XxMasterepicxX/ibex-sg13g2-chip/docs/ibex-flow.pdf

Building the Ibex chip on IHP SG13G2 with Synopsys | ibex-sg13g2-chip | Page 1 of 29

# Building the Ibex chip on IHP SG13G2 with Synopsys

### The whole flow from the repository, step by step

Item | Value
Author | Cesar Valentin
Repository | https://github.com/XxMasterepicxX/ibex-sg13g2-chip
Chip | flash_chip: Ibex, two 4 KiB memories, a serial loader, a scan chain and 25 pads
Kit | IHP SG13G2, 130 nm
Tools | Fusion Compiler, StarRC, PrimeTime SI, Formality, PrimePower, TestMAX, VCS, SpyGlass, RedHawk-SC, and KLayout with IHP's rules

Building the Ibex chip on IHP SG13G2 with Synopsys | ibex-sg13g2-chip | Page 2 of 29

## Contents

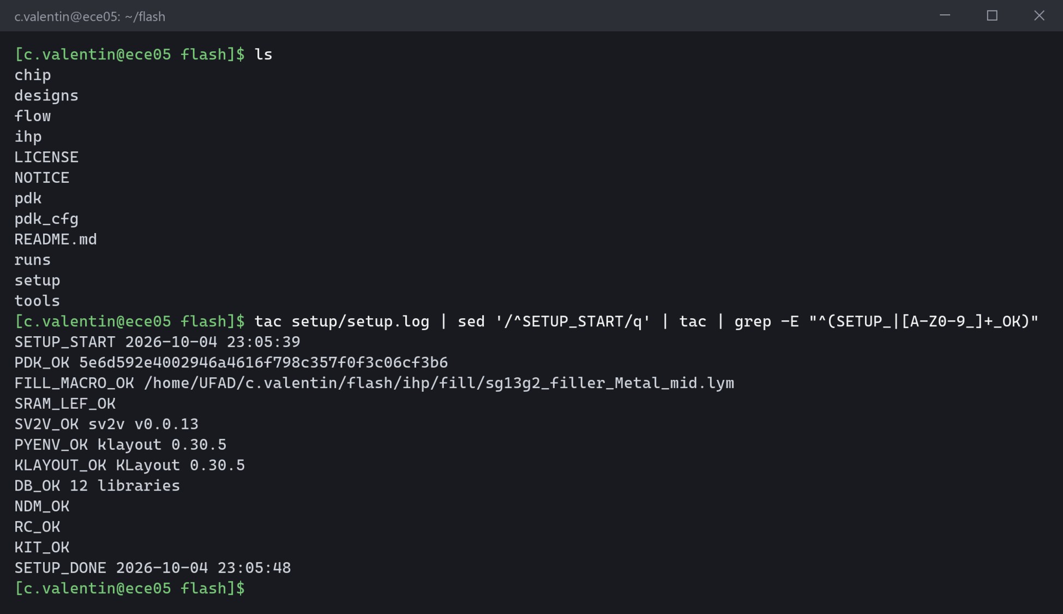
[picture p1: figure]

Building the Ibex chip on IHP SG13G2 with Synopsys | ibex-sg13g2-chip | Page 3 of 29

## Before you start

- Log in to a Linux server with the Synopsys and Ansys tools under /apps. Off campus, use the VPN.
- The scripts load the tools. To start a tool by hand, run source /apps/settings first.
- Fusion Compiler licenses are shared. When none is free, the build waits and tries again.
- Long steps run for hours. Start them under nohup so they keep running after you log out.

### Get the repository and set it up

Clone the repository into ~/flash and run setup once. Every script expects it there.

git clone https://github.com/XxMasterepicxX/ibex-sg13g2-chip.git ~/flash
bash ~/flash/setup/setup.sh

Setup takes about two hours. It downloads IHP's kit, builds KLayout, installs sv2v and the Python packages, and builds the Synopsys libraries and wire models from IHP's kit with your licenses. Those files are in Synopsys formats, so the repository does not hold them. Each step prints a line ending in _OK. If setup stops, the last line names the step and its log says why. Fix it and run setup.sh again. Steps that passed skip themselves.

Figure 1. The end of setup.log from a second run of setup.sh. Each step only checked its result.
Setup is done when ~/flash/setup/setup.log ends with SETUP_DONE.

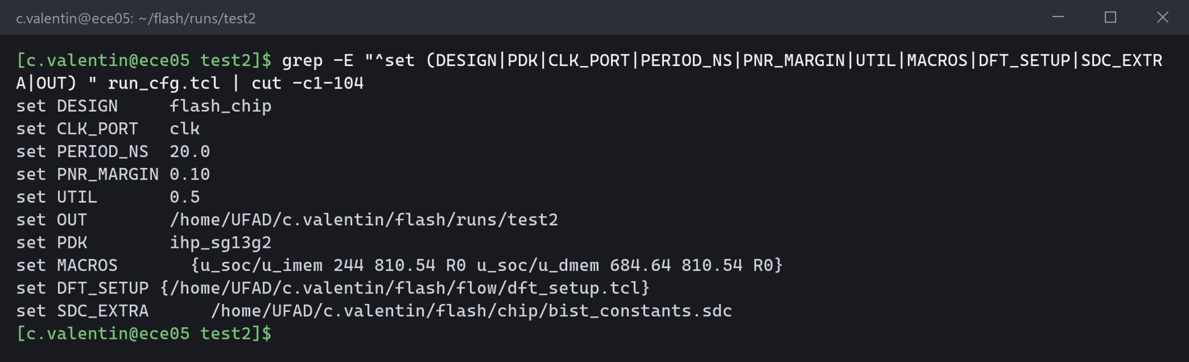
[picture p2: figure]

Building the Ibex chip on IHP SG13G2 with Synopsys | ibex-sg13g2-chip | Page 4 of 29

### What is in the repository

Folder | What it holds
setup/ | the one-time setup
flow/ | the Fusion Compiler flow fc_flow.tcl, run_fc.sh, signoff.sh, the checker check.py, chip finishing finish.sh and the fix loop eco.sh
pdk_cfg/ihp_sg13g2/ | every fact about the IHP kit: layers, cells, corners, pads, bond pads and fill
ihp/ | the scripts that build the Synopsys libraries, and the wire models
designs/flash_soc/ | the RTL, the testbench and the test programs
chip/ | the one-command build, margin rounds, proofs, review records and the release package
runs/<name>/ | one folder per build, made by the scripts

## Stage 1: Make a run

bash ~/flash/chip/new_run.sh my_chip

This makes ~/flash/runs/my_chip with one settings file, run_cfg.tcl, copied from chip/run_cfg.tcl
with the paths set to your home folder. Every later step reads it.
The screenshots come from fresh builds of this repository, named test1, test2 and walk; each caption names its run when it matters. Where they show test2 or walk, your folder is my_chip.

Figure 2. The main settings of the run.

Building the Ibex chip on IHP SG13G2 with Synopsys | ibex-sg13g2-chip | Page 5 of 29
Setting | What it does
DESIGN | the top module, flash_chip: the core inside its pad ring
PERIOD_NS | the clock period signed off, 20 ns or 50 MHz
PNR_MARGIN | 0.10 makes Fusion Compiler aim for a period 10% shorter, 18 ns, to leave room
CORE_SIZE | the core is 900 by 945 µm. With CORE_SIZE set, UTIL is not used
MAX_LAYER | the top routing layer, Metal5. Routing starts at Metal2, so the chip routes on 4 layers
MACROS | where the two memories go, in µm from the lower left corner
DFT_SETUP | how to build the scan chain
SDC_EXTRA | holds the memories' unused self-test clocks at 0 for timing
OUT | the run folder itself; run_fc.sh refuses to start if it is not

The chip must work at three corners. Each pairs a voltage and temperature with its library and wire model.

Corner | Voltage | Temperature | Checked mainly for | Wire model
slow | 1.08 V | 125 C | setup | worst
typ | 1.2 V | 25 C | power | typical
fast | 1.32 V | -40 C | hold | best

## Stage 2: Run it stage by stage

make_chip.sh runs stages 3 to 8 in order, and makes the run first if it does not exist. The first time, run it one stage at a time. STOP_AT stops it after the stage you name. Look at what that stage made, then run the same command with the next stage.

STOP_AT=synth bash ~/flash/chip/make_chip.sh my_chip

STOP_AT | Stops after
synth | stage 3, synthesis and scan, about 4 minutes
route | stage 4, place and route, about 12 minutes
finish | stage 5, chip finishing, about an hour
signoff | stage 6, the first signoff, about an hour and three quarters

After signoff, leave STOP_AT out. The build then runs stages 7 and 8 and stops at stage 9, when the review records are ready to sign. Steps that passed are skipped, so the same command picks up where the last one stopped. If a step fails, the log names it and says where to look. Each stage logs the tool command it runs, and the stages below show it too. Put MARGIN=hand in front to do stage 7 yourself.

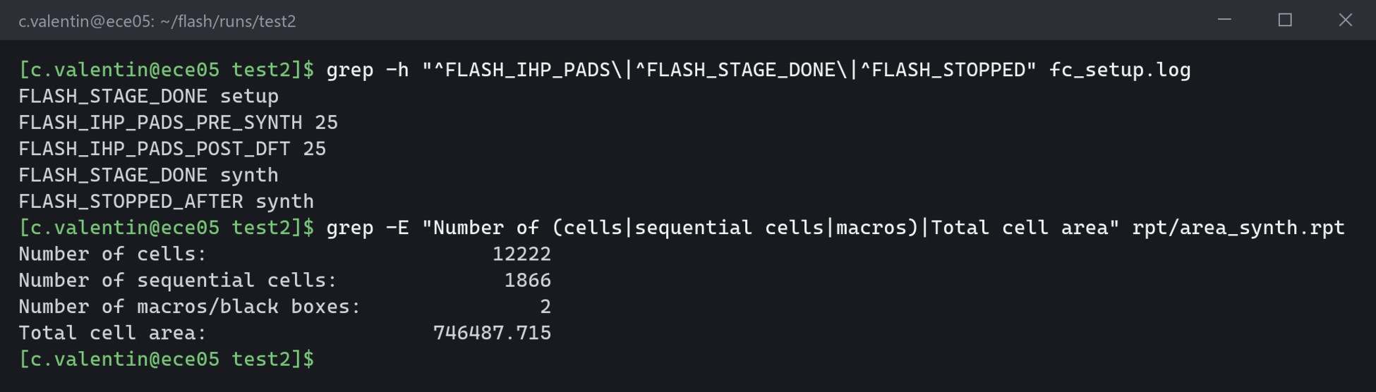
[picture p3: figure]

Building the Ibex chip on IHP SG13G2 with Synopsys | ibex-sg13g2-chip | Page 6 of 29

Run the long stages under nohup and follow the log:

STOP_AT=signoff nohup bash ~/flash/chip/make_chip.sh my_chip > /dev/null 2>&1 & tail -f ~/flash/runs/my_chip/make_chip.log

The commands for looking at results use RUN for the run folder:

RUN=~/flash/runs/my_chip

Do not trust FC_EXIT=0 in a Fusion Compiler log. It prints even after an error. A session worked only if its log has FLASH_FLOW_DONE, or FLASH_STOPPED_AFTER when it was asked to stop.

## Stage 3: Synthesis and scan

STOP_AT=synth bash ~/flash/chip/make_chip.sh my_chip

It runs STOP_AFTER=synth ~/flash/flow/run_fc.sh $RUN. Fusion Compiler builds the RTL from IHP's standard cells and inserts the scan chain, which lets a tester load and read every flip-flop. The session stops after synthesis so you can check the result.

Figure 3. The synthesis log and area report. All 25 pads survive scan insertion.
Synthesis is done when the log shows FLASH_IHP_PADS_POST_DFT 25. The netlist has 12,222 cells, 1,866 of them sequential, and the two memories.
Look at it yourself. The log tells the story of the session, and the area report counts the cells:

less $RUN/fc_setup.log
less $RUN/rpt/area_synth.rpt

## Stage 4: Place and route

STOP_AT=route bash ~/flash/chip/make_chip.sh my_chip

It runs START_AT=floorplan ~/flash/flow/run_fc.sh $RUN. This second session runs floorplan, pg,
place, cts, route and final, and saves the design after each. START_AT restarts from a saved step.

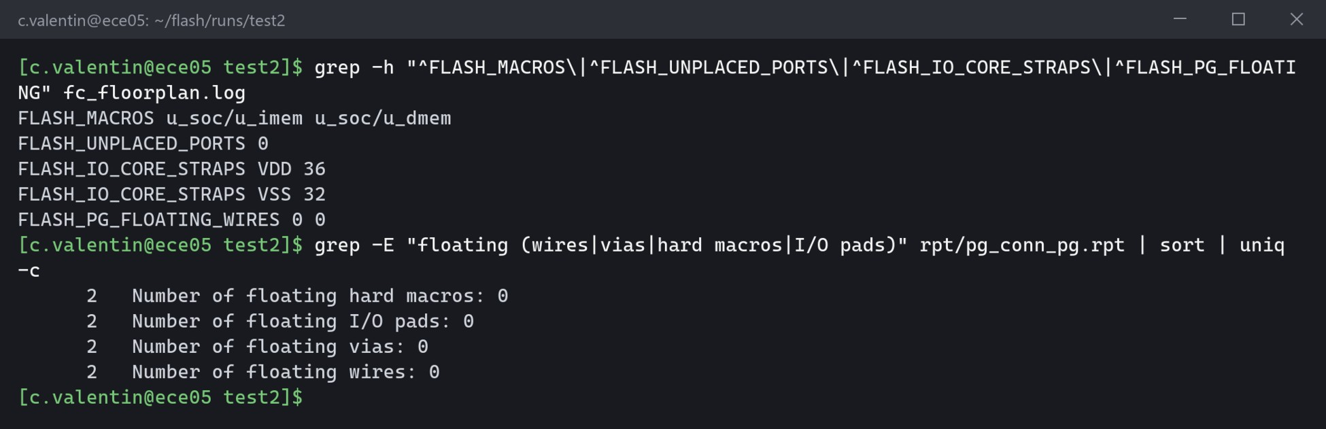
[picture p4: figure]
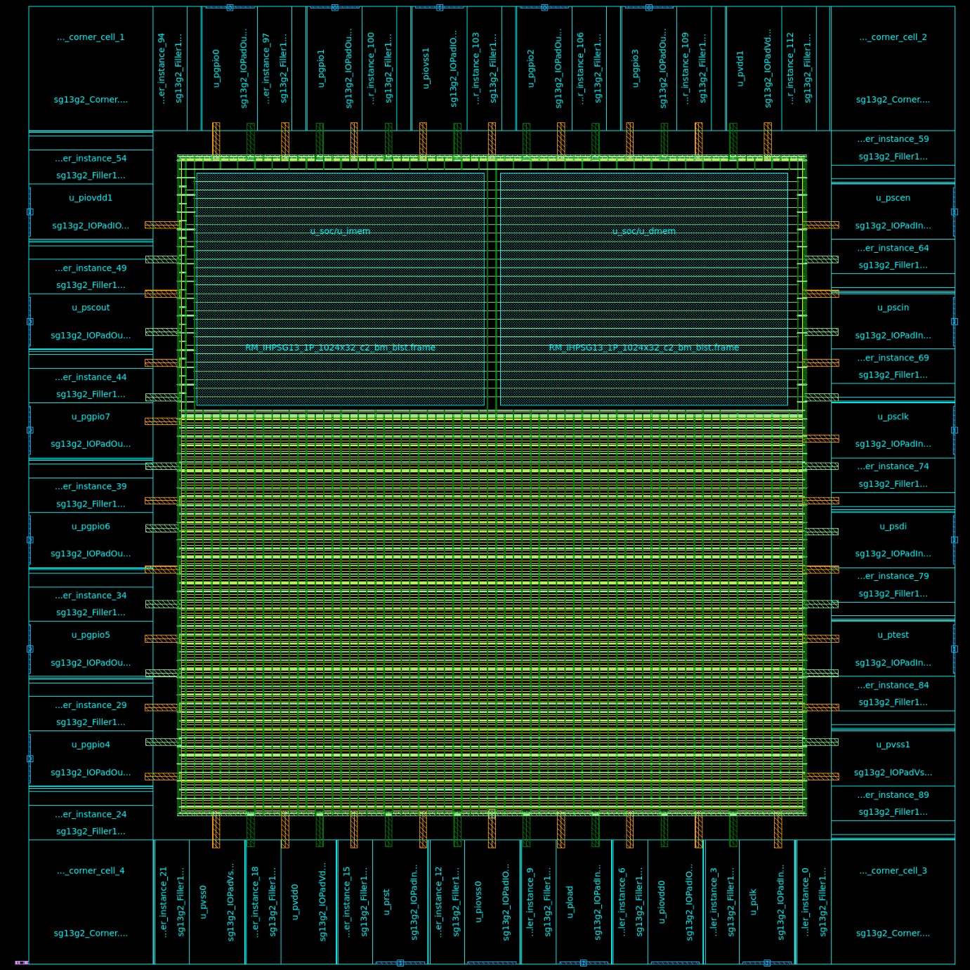
[picture p5: figure]

Building the Ibex chip on IHP SG13G2 with Synopsys | ibex-sg13g2-chip | Page 7 of 29

### 4.1 Floorplan and power grid

The floorplan sets the die size, places the 25 pads in their ring and puts the two memories at the top of the core. The power grid brings VDD and VSS from the pad ring to every cell row.

Figure 4. The floorplan and power grid reports. Both memories are placed, no port is unplaced and nothing floats.

Figure 5. After the power grid: the pad ring, the two memories at the top, and the grid stripes below them.
The floorplan and power grid are done when FLASH_UNPLACED_PORTS is 0 and the power grid report shows no floating wires, vias, memories or pads.

### 4.2 Placement and clock tree

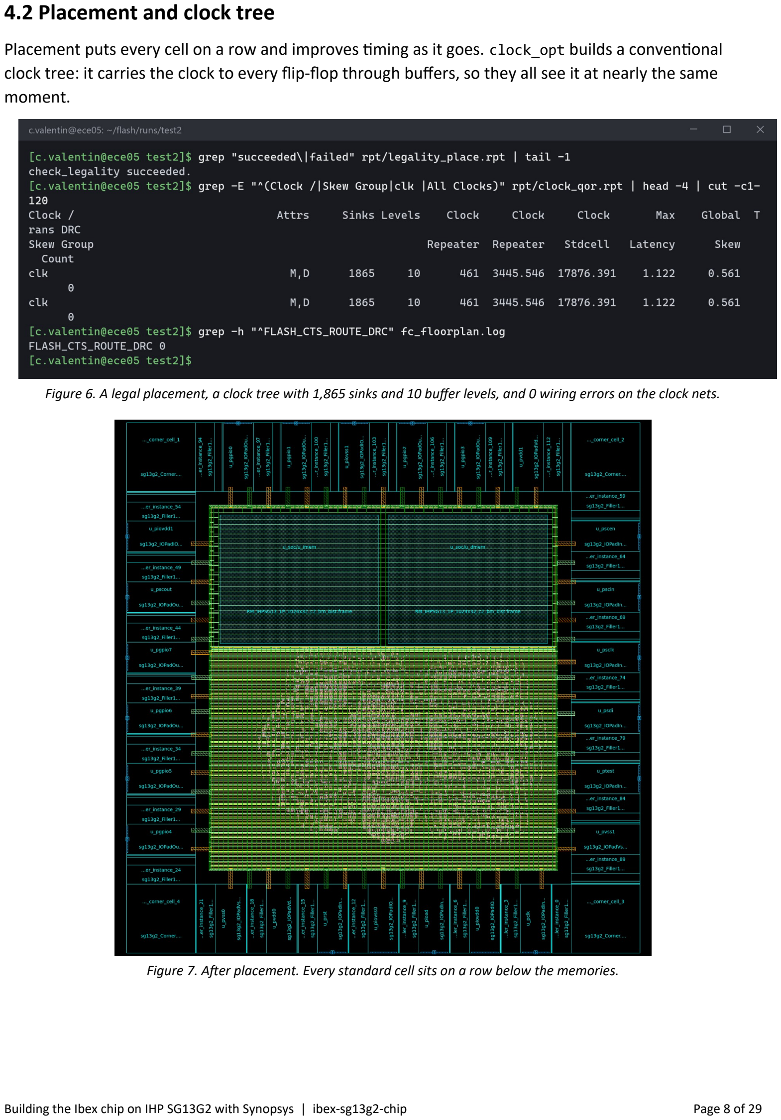
[picture p6: page 8]

Building the Ibex chip on IHP SG13G2 with Synopsys | ibex-sg13g2-chip | Page 8 of 29

Placement puts every cell on a row and improves timing as it goes. clock_opt builds a conventional clock tree: it carries the clock to every flip-flop through buffers, so they all see it at nearly the same moment.

Figure 6. A legal placement, a clock tree with 1,865 sinks and 10 buffer levels, and 0 wiring errors on the clock nets.

Figure 7. After placement. Every standard cell sits on a row below the memories.

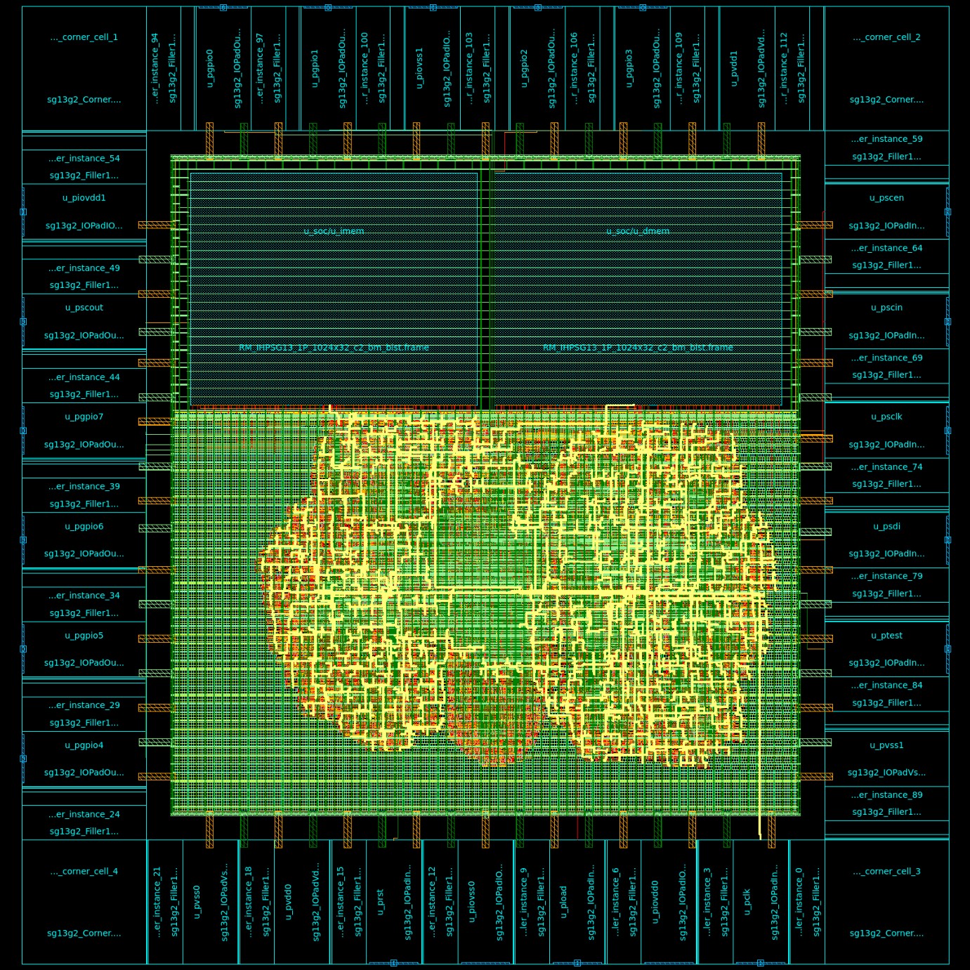
[picture p7: figure]
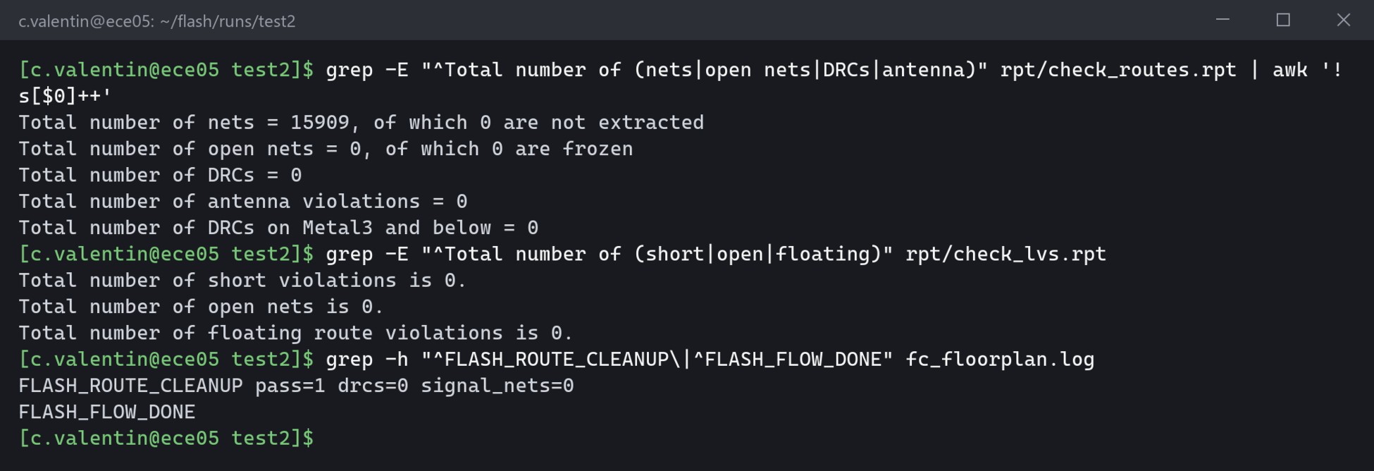
[picture p8: figure]

Building the Ibex chip on IHP SG13G2 with Synopsys | ibex-sg13g2-chip | Page 9 of 29

Figure 8. After the clock tree. The yellow clock nets spread from the clock pad to every flip-flop.
The clock wires go in first. The flow then adds decap cells, small capacitors that steady the supply, with their own Metal1, and reroutes the clock nets around them with route_eco. The log line FLASH_CTS_ROUTE_DRC must read 0.

### 4.3 Routing

Routing draws every connection in Metal2 to Metal5 and repairs its own rule errors.

Figure 9. The routing checks: no open nets, routing errors, antenna errors or shorts.

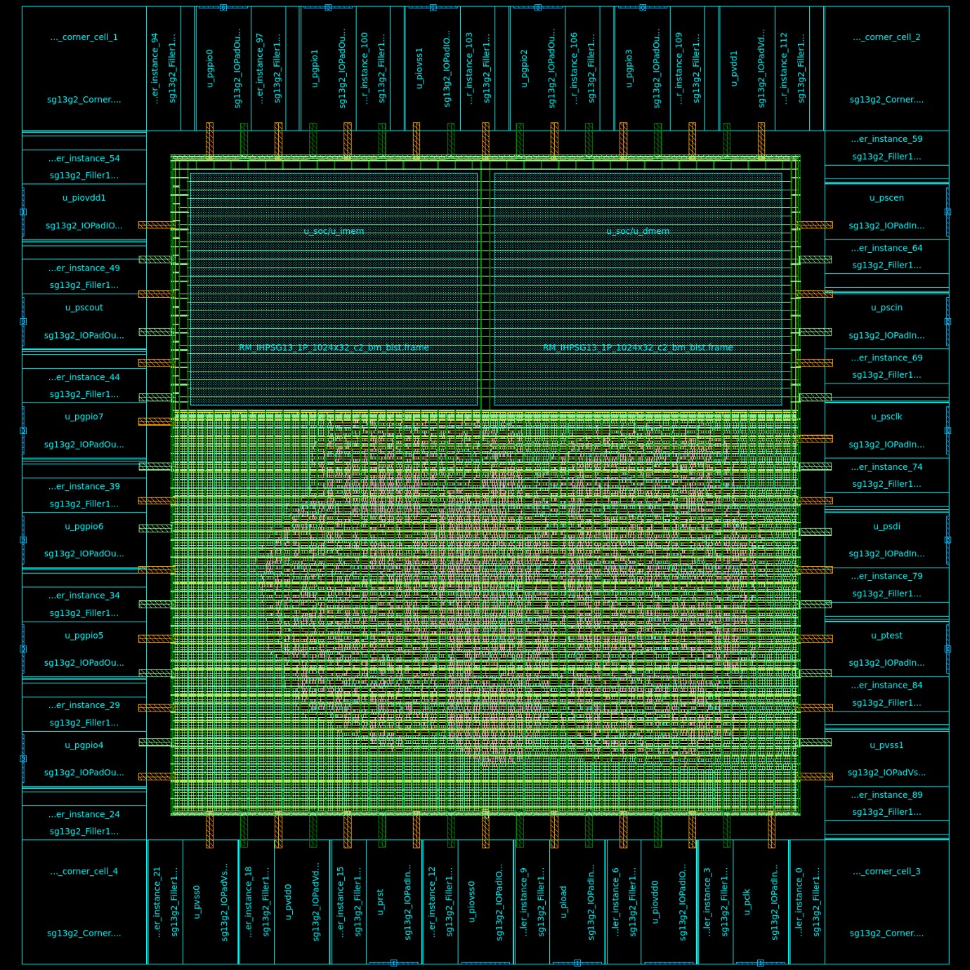
[picture p9: figure]

Building the Ibex chip on IHP SG13G2 with Synopsys | ibex-sg13g2-chip | Page 10 of 29

Figure 10. After routing. Signal wires on Metal2 to Metal5 cover the core.
Routing is done when check_routes reports 0 DRCs and 0 open nets, and the short check reports 0 shorts.

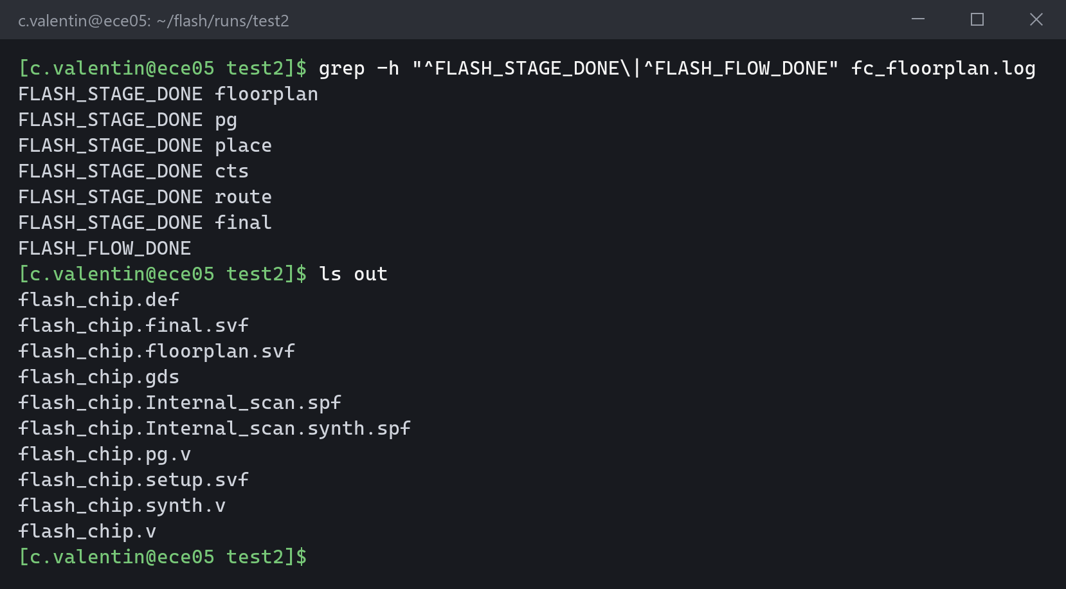
[picture p10: figure]
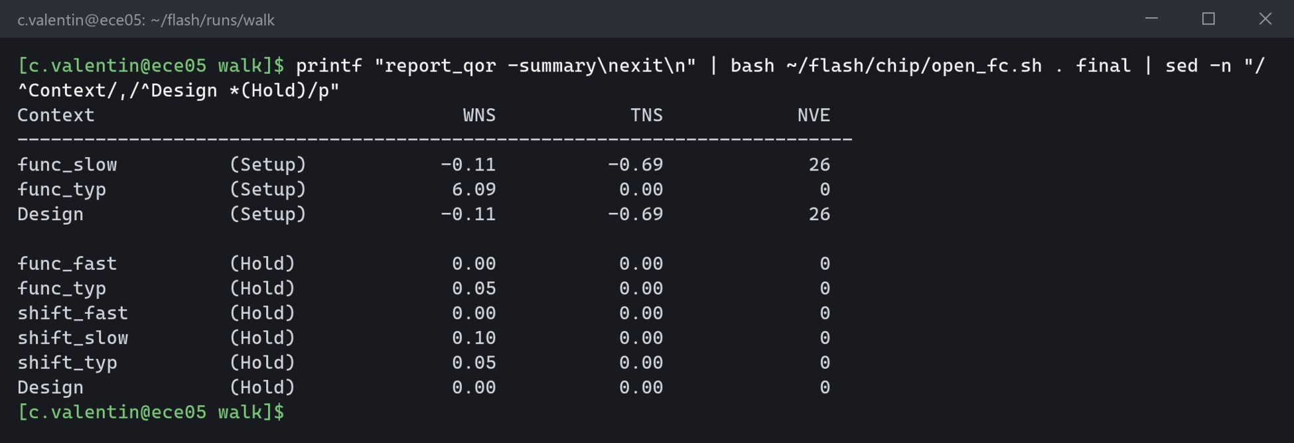
[picture p11: figure]

Building the Ibex chip on IHP SG13G2 with Synopsys | ibex-sg13g2-chip | Page 11 of 29

### 4.4 Final checks and files

Figure 11. Every step finished, and the files in out/: the layout, the netlists, the placed design and the inputs for Formality and the scan test.
Fusion Compiler judges timing against its 18 ns target. Stage 6 signs off the real 20 ns period with separate tools. Stage 4 is done when the log ends with FLASH_FLOW_DONE.
Look at it yourself. open_fc.sh opens any saved step read-only: floorplan, pg, place, cts, route or final. Ask Fusion Compiler for the timing summary and the worst path, then open the layout. The GUI needs an X display, such as MobaXterm or ssh -X.

bash ~/flash/chip/open_fc.sh $RUN final
report_qor -summary
report_timing
gui_start

Figure 12. report_qor -summary in open_fc.sh on the final step, per corner and mode.

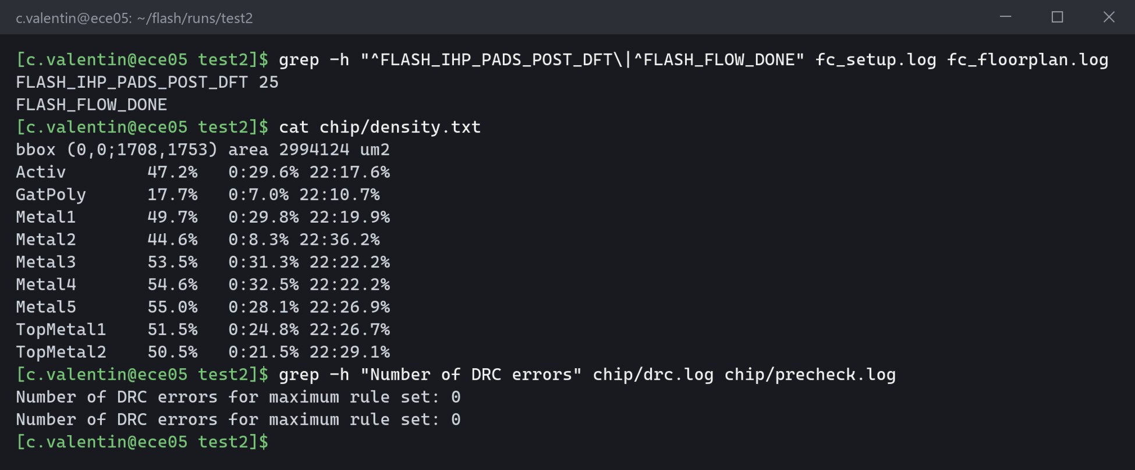
[picture p12: figure]

Building the Ibex chip on IHP SG13G2 with Synopsys | ibex-sg13g2-chip | Page 12 of 29

These numbers are against Fusion Compiler's own 18 ns target and 1 ns of clock uncertainty, so a small negative setup slack here is normal. Stage 6 signs off the real 20 ns period.

## Stage 5: Finish the chip

STOP_AT=finish bash ~/flash/chip/make_chip.sh my_chip

It runs METAL_FILL=mid bash ~/flash/flow/finish.sh $RUN 75 bondpads. finish.sh puts a bond pad
on every pad, a seal ring 75 µm out around the edge, and metal fill in every empty area, because the factory polishes each layer flat and needs even density. Then it runs whole-chip DRC and IHP's pre-check, the rule set IHP runs before it accepts a design. Both run at once. The step takes about an hour. Each DRC run goes through flow/drc.sh, which stops a run that stalls past 100 minutes, DRC_TIME_LIMIT, and runs it once more.
Before that, make_chip.sh records the signoff inputs that the chip DRC result is tied to, so run this stage through it rather than finish.sh alone.

Figure 13. The pad count, metal density and both DRC results. Every metal is inside IHP's limits and both DRC runs found 0 errors.

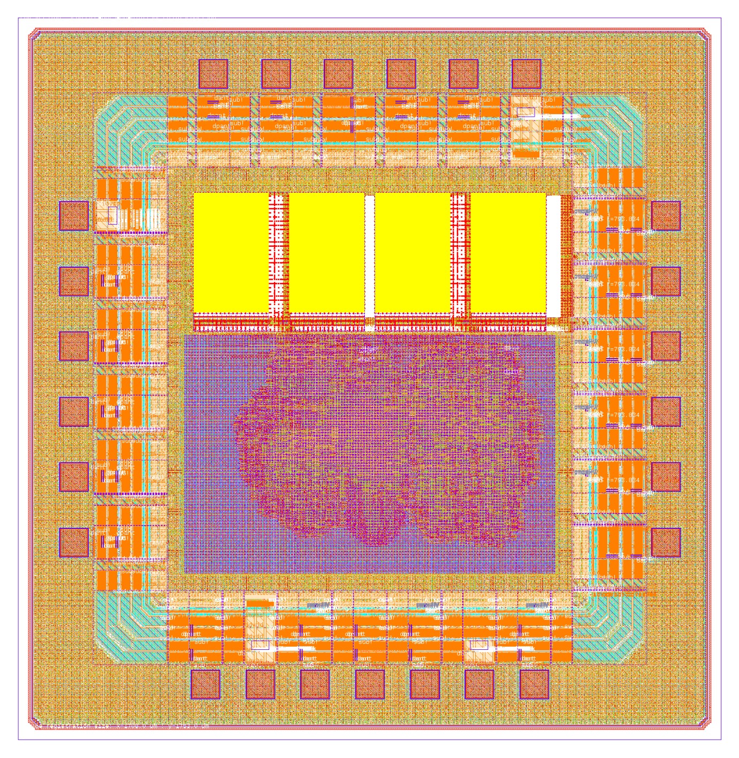
[picture p13: figure]

Building the Ibex chip on IHP SG13G2 with Synopsys | ibex-sg13g2-chip | Page 13 of 29

Figure 14. The finished chip in KLayout: the seal ring, 25 bond pads, the two memories in yellow, and fill everywhere else.

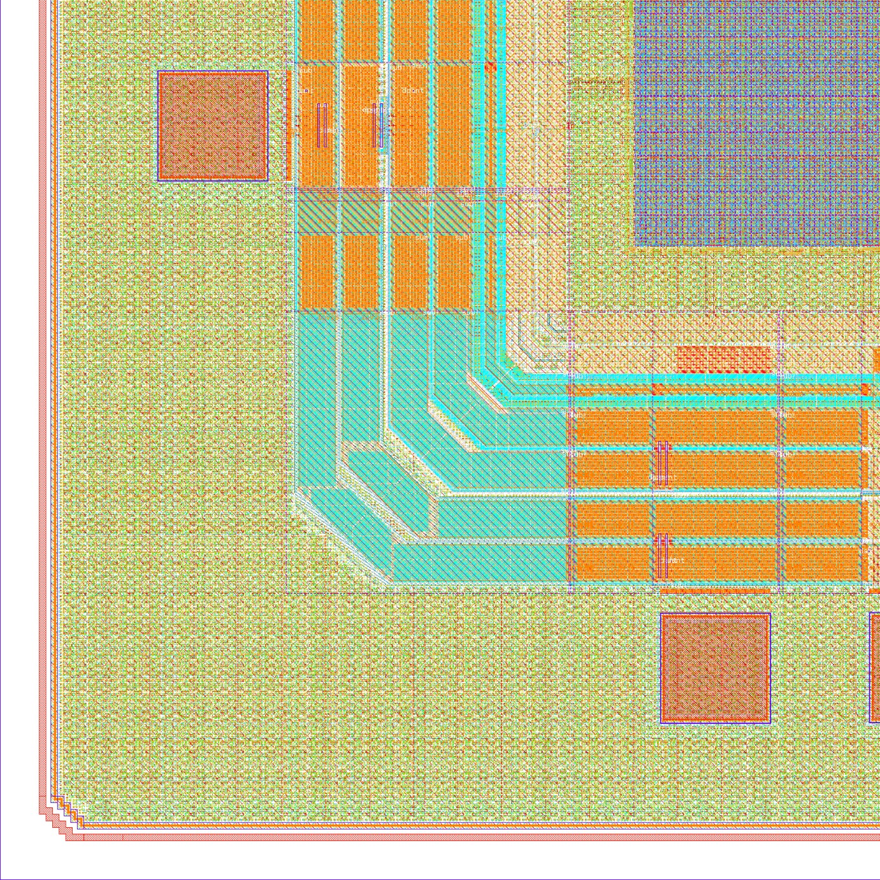
[picture p14: figure]

Building the Ibex chip on IHP SG13G2 with Synopsys | ibex-sg13g2-chip | Page 14 of 29

Figure 15. The lower left corner, 560 µm across. From the outside in: the seal ring, two bond pads, the pad ring's corner cell and the core edge. The fine pattern is metal fill.
IHP requires 35% to 60% metal on Metal1 to Metal5 and 25% to 70% on TopMetal1 and TopMetal2. Stage 5 is done when every layer in chip/density.txt is inside those limits and both DRC runs report 0 errors.
Look at it yourself in KLayout, with IHP's layer colors. Tools, Marker Browser loads the DRC results from $RUN/chip/drc. Like the Fusion Compiler GUI, it needs an X display.

bash ~/flash/chip/open_klayout.sh $RUN

## Stage 6: Signoff

STOP_AT=signoff nohup bash ~/flash/chip/make_chip.sh my_chip > /dev/null 2>&1 &

It runs ~/flash/flow/signoff.sh $RUN. Signoff checks the design with tools that did not build it. StarRC extracts every wire with the typical, worst and best wire models. PrimeTime checks timing, crosstalk and electrical limits at three corners in normal and scan mode, six runs in all. Formality proves the netlist matches the RTL. PrimePower adds up the power. KLayout runs IHP's DRC and LVS on the block and LVS on the whole chip. Last, check.py writes one line per check to signoff/CHECK.txt.

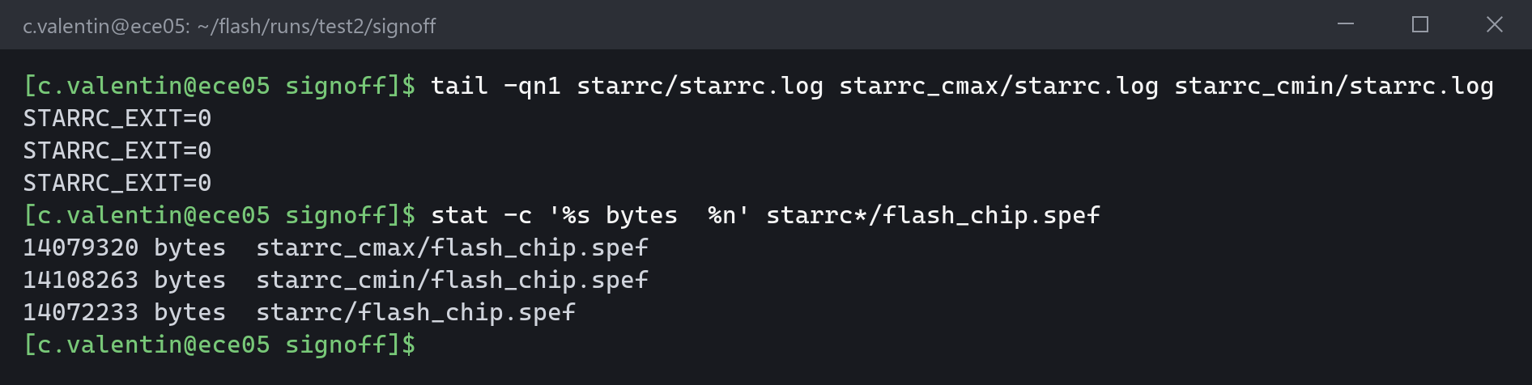
[picture p15: figure]
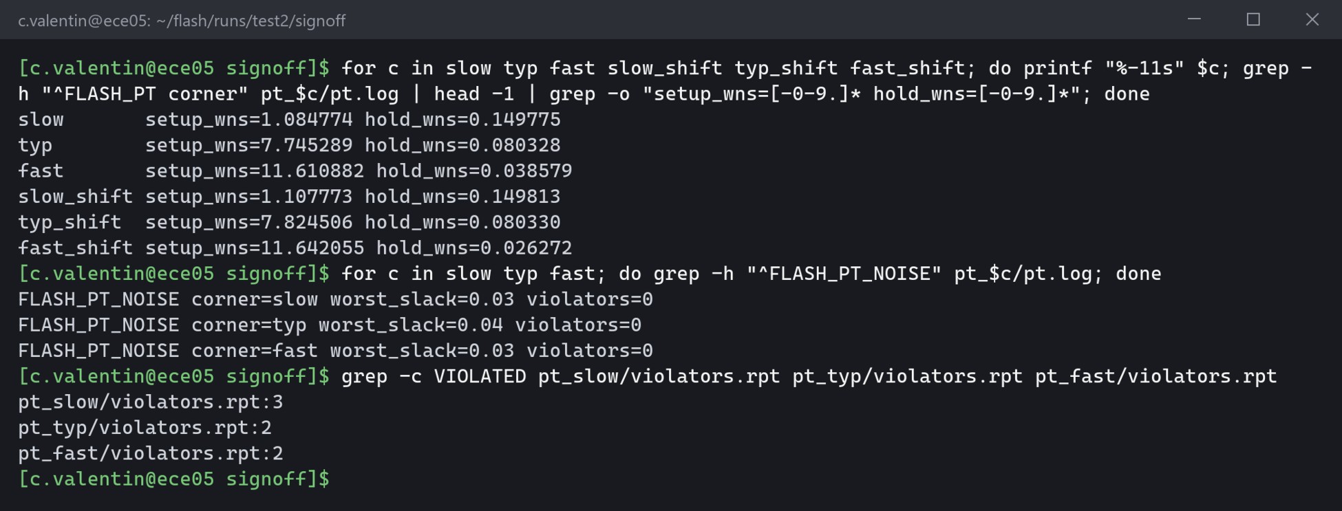
[picture p16: figure]

Building the Ibex chip on IHP SG13G2 with Synopsys | ibex-sg13g2-chip | Page 15 of 29

The worst and best wire models come from the ranges in IHP's process specification, see ihp/rc/DERIVATION.md. IHP's open kit has DRC and LVS rules only for KLayout, Magic and Netgen, not for IC Validator, and IHP's tapeout check runs in KLayout, so DRC and LVS use KLayout. Fusion Compiler's own route and LVS checks in Stage 4 also pass. Signoff takes about an hour and three quarters.

### 6.1 Wire delays, StarRC

Figure 16. StarRC finished with all three wire models, one SPEF file each.

### 6.2 Timing, PrimeTime

Figure 17. The PrimeTime runs. Setup, hold and noise pass everywhere. Each corner lists electrical violations.
Slow setup has +1.08 ns to spare. Fast hold has only +0.039 ns in normal mode and +0.026 ns in scan mode. That passes but leaves little room for differences between real chips. The electrical violations are two memory outputs driving slightly more load than allowed, and the flip-flop u_soc/sclk_s_reg[2]. It uses only its inverted output, so its other output is under its smallest allowed load. Stage 7 fixes them.

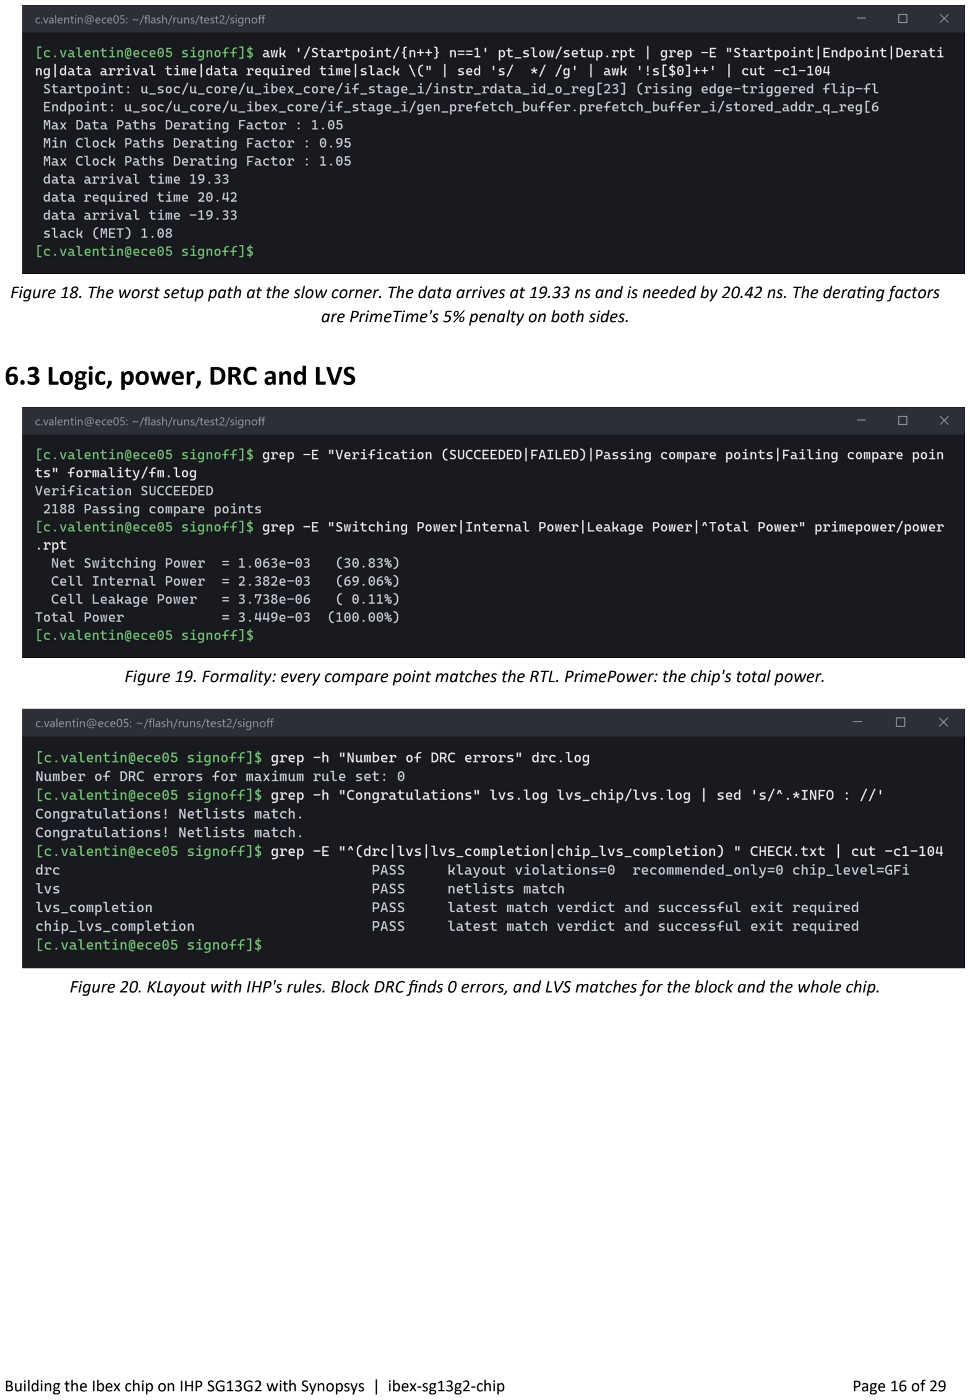
[picture p17: page 16]

Building the Ibex chip on IHP SG13G2 with Synopsys | ibex-sg13g2-chip | Page 16 of 29

Figure 18. The worst setup path at the slow corner. The data arrives at 19.33 ns and is needed by 20.42 ns. The derating factors are PrimeTime's 5% penalty on both sides.

### 6.3 Logic, power, DRC and LVS

Figure 19. Formality: every compare point matches the RTL. PrimePower: the chip's total power.

Figure 20. KLayout with IHP's rules. Block DRC finds 0 errors, and LVS matches for the block and the whole chip.

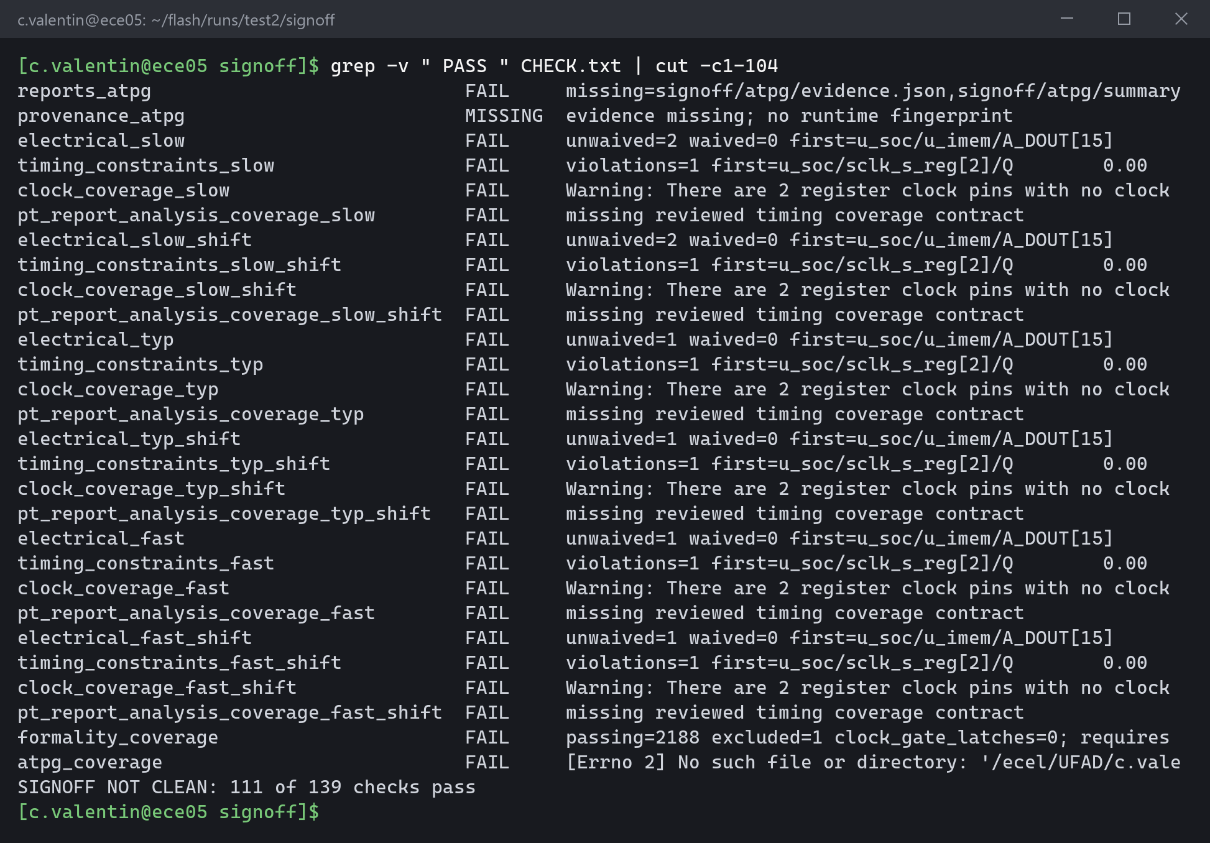
[picture p18: figure]

Building the Ibex chip on IHP SG13G2 with Synopsys | ibex-sg13g2-chip | Page 17 of 29

### 6.4 The checker

Figure 21. The checks still failing after the first signoff. 111 of 139 pass.
The failing rows are the scan test, which is stage 8, the unsigned review records, stage 9, and the electrical and constraint rows from 6.2, which stage 7 fixes. Setup, hold, noise, Formality, DRC and both LVS runs already pass.
Look at it yourself. Every check is one line of CHECK.txt, and each PrimeTime run keeps its reports in its own folder:

less $RUN/signoff/CHECK.txt
less $RUN/signoff/pt_slow/setup.rpt less $RUN/signoff/pt_fast/hold.rpt

## Stage 7: Margin rounds

The hold floor is +0.09 ns of hold slack at the fast corner. The first signoff usually leaves fast hold under it, along with the 6.2 violations or a few noise victims. Any fix can break another corner. PrimeTime fixes hold at the fast corner without seeing the slow one. So every list of changes is tested at all three corners in both modes before Fusion Compiler applies it.
By default make_chip.sh runs the rounds for you. With MARGIN=hand it stops after the first signoff and you do the same work yourself.

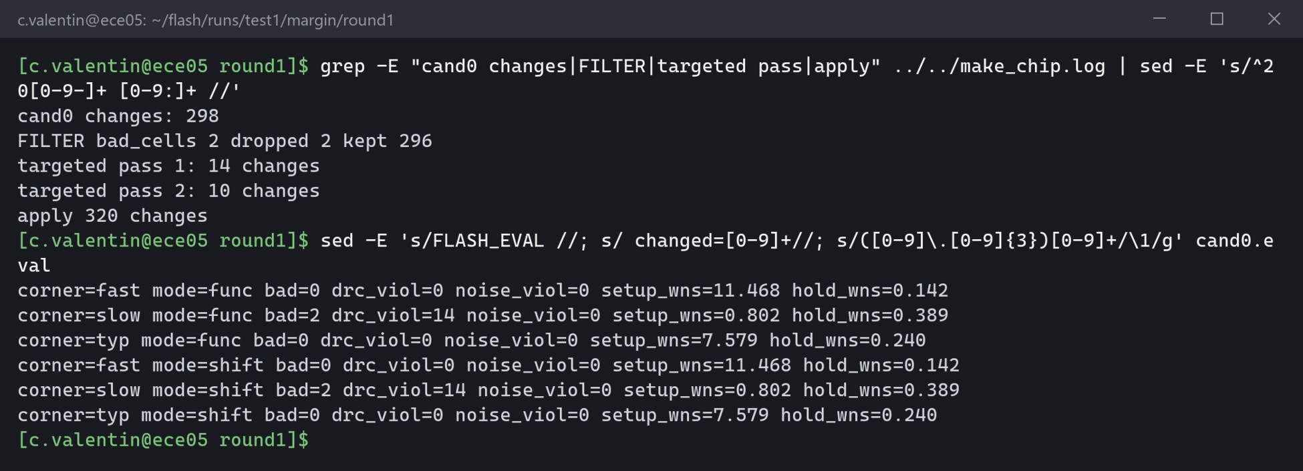
[picture p19: figure]
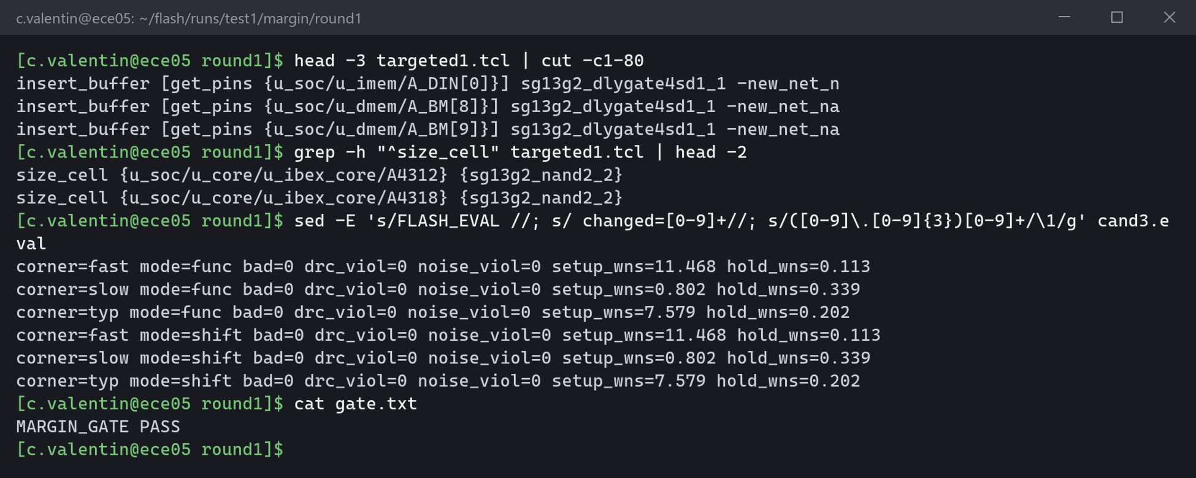
[picture p20: figure]

Building the Ibex chip on IHP SG13G2 with Synopsys | ibex-sg13g2-chip | Page 18 of 29

### 7.1 Automatic rounds

bash ~/flash/chip/margin_fix.sh $RUN

1. PrimeTime proposes noise, load and hold fixes and changes nothing.
2. The list is tested at every corner and mode. A changed cell that leaves a path under +0.6 ns at slow or +0.2 ns at typ and fast is dropped, and the shorter list is tested again.
3. Targeted fixes cover the rest. A noise victim's driver gets a buffer after it. A driver over its limit gets one size larger. A hold endpoint gets a delay cell in front of it.
4. Fusion Compiler applies the list only if slow setup keeps +0.6 ns and fast hold reaches the hold floor. The chip is finished and signed off again, and the round is undone if any check that passed before fails.
make_chip.sh runs up to three rounds, each kept in $RUN/margin/roundN. A round can be undone when real routing makes a new noise victim that PrimeTime's estimate did not show. The next round then reads that attempt's noise report and buffers those victims first.

Figure 22. Round 1 on test1. Of 298 proposed changes, 2 left a slow path under +0.6 ns, and the test dropped both.

Figure 23. The targeted fixes and the final test of all 320 changes. Fast hold is +0.113 ns, slow setup keeps +0.802 ns, and no corner has a bad cell, electrical or noise violation.

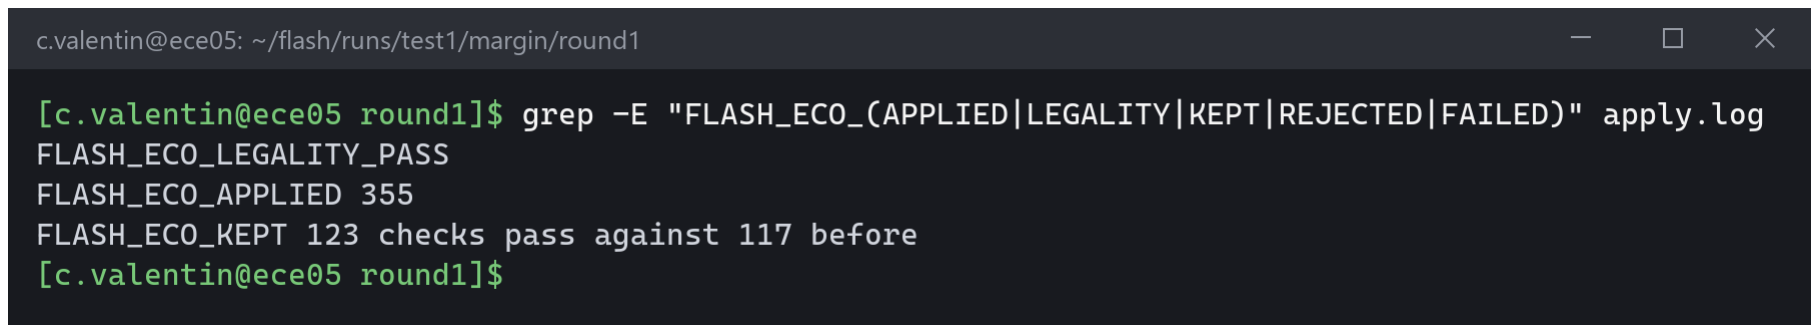
[picture p21: figure]
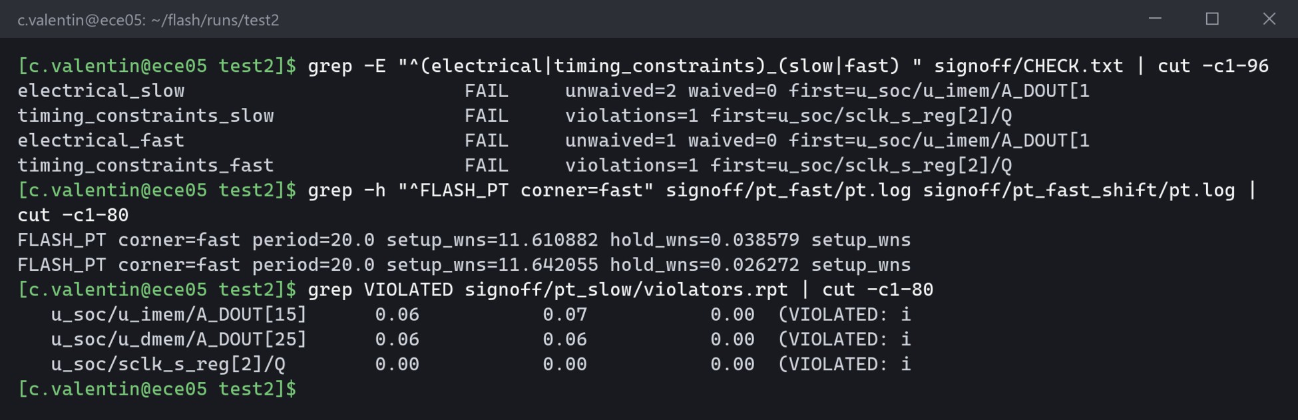
[picture p22: figure]
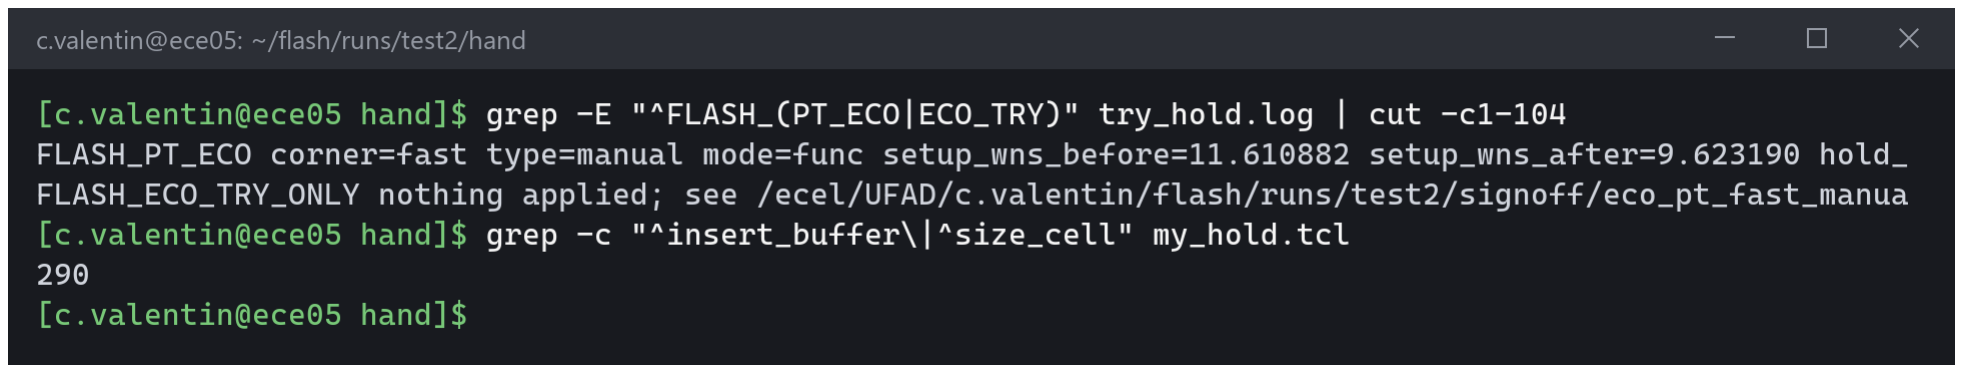
[picture p23: figure]

Building the Ibex chip on IHP SG13G2 with Synopsys | ibex-sg13g2-chip | Page 19 of 29

Figure 24. The verdict. The placement stayed legal and 123 checks pass against 117 before, so the round is kept.

### 7.2 Fixing it by hand

MARGIN=hand bash ~/flash/chip/make_chip.sh my_chip

The build stops after the first signoff and prints what needs fixing. The names below come from test2. Read your own reports at each step.

Figure 25. Where test2 stopped: the 6.2 violations, and fast hold under the hold floor.
First ask PrimeTime for hold fixes. hold_both.tcl asks for +0.15 ns of hold in both modes while keeping +0.5 ns of setup at the fast corner. TRY_ONLY=1 stops the fix loop after PrimeTime, so the design does not change.

mkdir -p $RUN/hand && cd $RUN/hand
TRY_ONLY=1 MANUAL_CHANGES=~/flash/chip/margin/hold_both.tcl \ ~/flash/flow/eco.sh $RUN fast manual
cp $RUN/signoff/eco_pt_fast_manual/eco_changes.tcl my_hold.tcl

Figure 26. PrimeTime's proposal at the fast corner: 290 changes written, nothing applied.
Then test the list. fc_pins.txt names the memory outputs you will buffer in Fusion Compiler. PrimeTime cannot judge the load of a buffer it has not placed, so the test leaves those pins out.

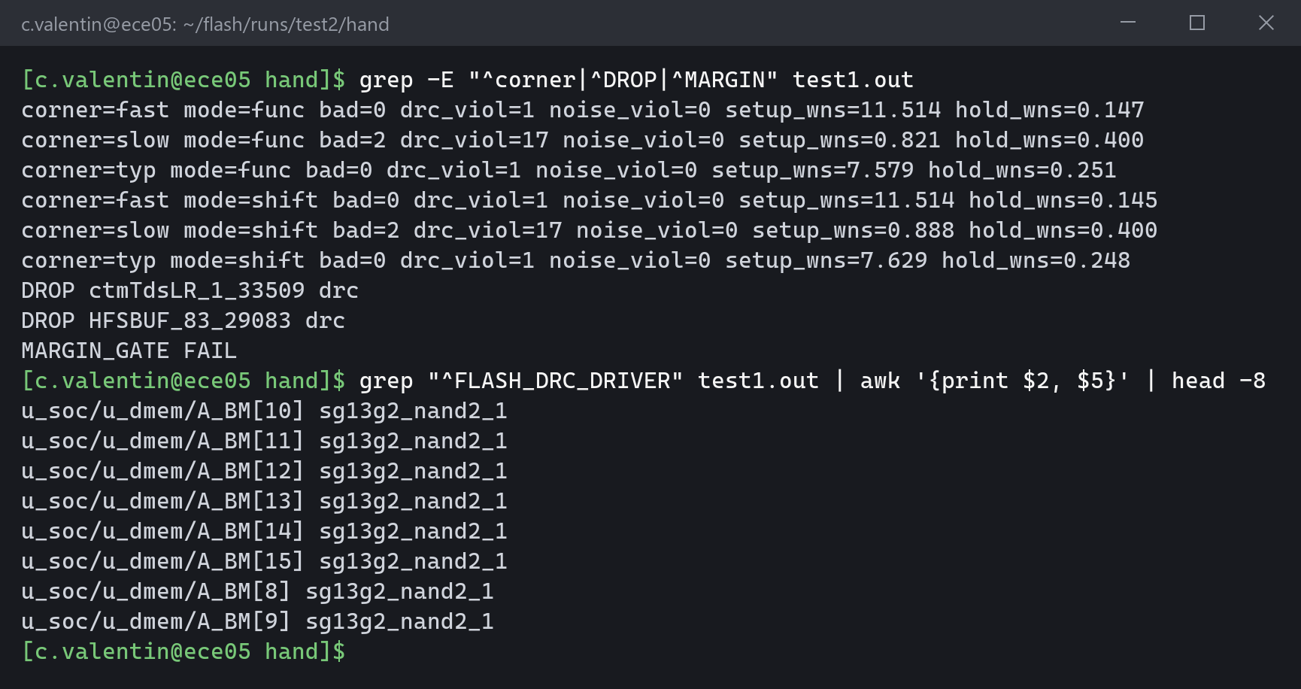
[picture p24: figure]

Building the Ibex chip on IHP SG13G2 with Synopsys | ibex-sg13g2-chip | Page 20 of 29

printf "u_soc/u_imem/A_DOUT[15]\nu_soc/u_dmem/A_DOUT[25]\n" > fc_pins.txt bash ~/flash/chip/margin/test_list.sh $RUN my_hold.tcl fc_pins.txt

Figure 27. The first test. Fast hold rises to +0.147 ns, but 2 changed cells break a transition limit at slow. The test names them and lists the weak drivers.
Fix one kind of problem at a time and test after each change. Drop the bad cells with filter_changes.py. Add one size_cell line per driver the test lists, one size larger. The block shows one. Put a delay cell in front of each endpoint under the hold floor.

python3 ~/flash/chip/margin/filter_changes.py my_hold.tcl my_hold2.tcl \ $RUN/margin/test_my_hold/bad_cells_*.txt
cp my_hold2.tcl my_hold3.tcl
echo current_instance >> my_hold3.tcl
echo "size_cell {u_soc/u_core/u_ibex_core/A4285} {sg13g2_nand2_2}" >> my_hold3.tcl echo "insert_buffer [get_pins {u_soc/u_imem/A_DIN[0]}] sg13g2_dlygate4sd1_1 \ -new_net_names {net_HAND_H1} -new_cell_names {U_HAND_H1}" >> my_hold3.tcl
bash ~/flash/chip/margin/test_list.sh $RUN my_hold3.tcl fc_pins.txt

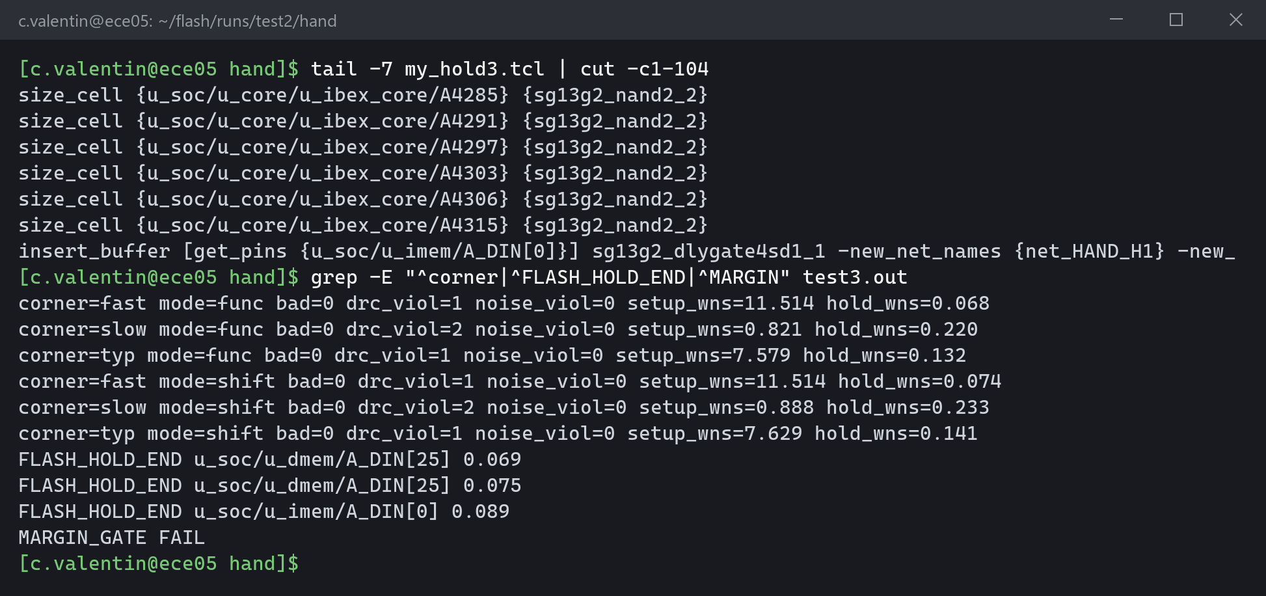
[picture p25: figure]
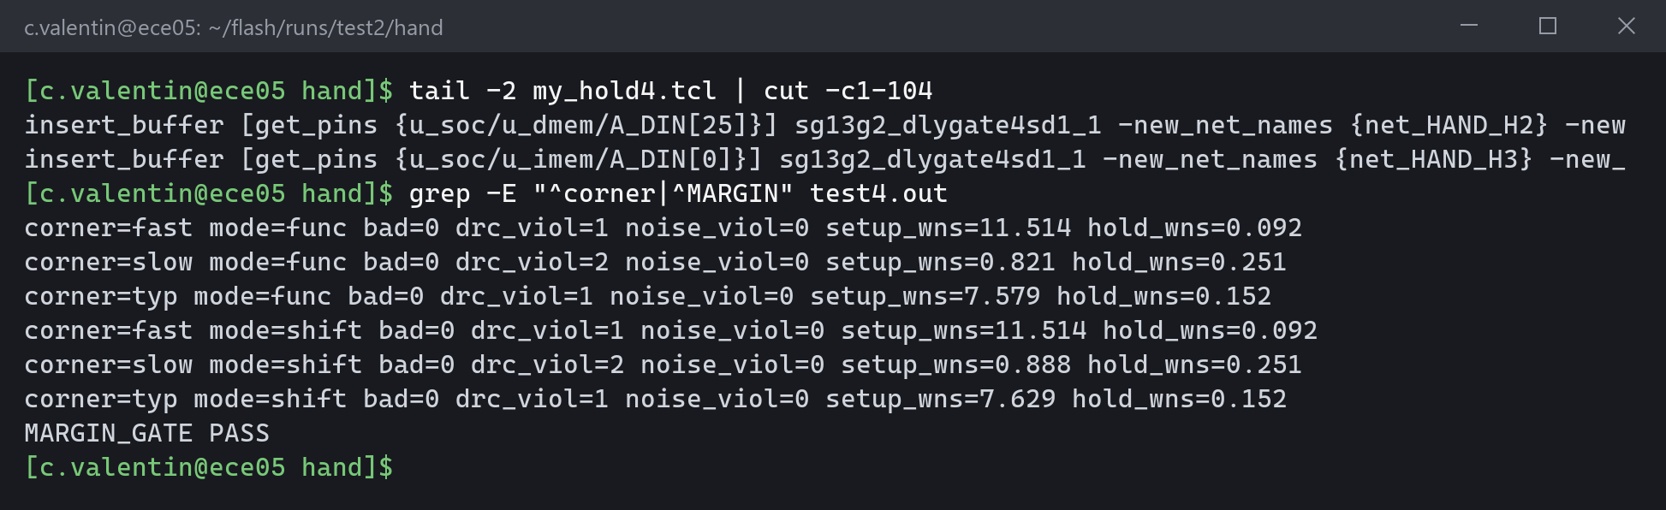
[picture p26: figure]

Building the Ibex chip on IHP SG13G2 with Synopsys | ibex-sg13g2-chip | Page 21 of 29

Figure 28. After dropping the bad cells, upsizing the listed drivers and adding one delay cell. The transition violations are gone, but one memory input fell under the hold floor.
Each fix moves something else. Here the larger drivers made the path to dmem/A_DIN[25] faster. One more delay cell there, and a second on imem/A_DIN[0], which was 0.001 ns short, bring every corner and mode through.

cp my_hold3.tcl my_hold4.tcl
echo "insert_buffer [get_pins {u_soc/u_dmem/A_DIN[25]}] sg13g2_dlygate4sd1_1 \ -new_net_names {net_HAND_H2} -new_cell_names {U_HAND_H2}" >> my_hold4.tcl echo "insert_buffer [get_pins {u_soc/u_imem/A_DIN[0]}] sg13g2_dlygate4sd1_1 \ -new_net_names {net_HAND_H3} -new_cell_names {U_HAND_H3}" >> my_hold4.tcl bash ~/flash/chip/margin/test_list.sh $RUN my_hold4.tcl fc_pins.txt

Figure 29. The final test. Fast hold is +0.092 ns, slow setup keeps +0.821 ns, and the gate passes.
Last, apply it. The Fusion Compiler script is the tested list, a buffer on each memory output in fc_pins.txt, and sclk_swap.tcl, which swaps the flip-flop for one without the unused output. The fix loop applies it, then finishes and signs off the chip as in 7.1.

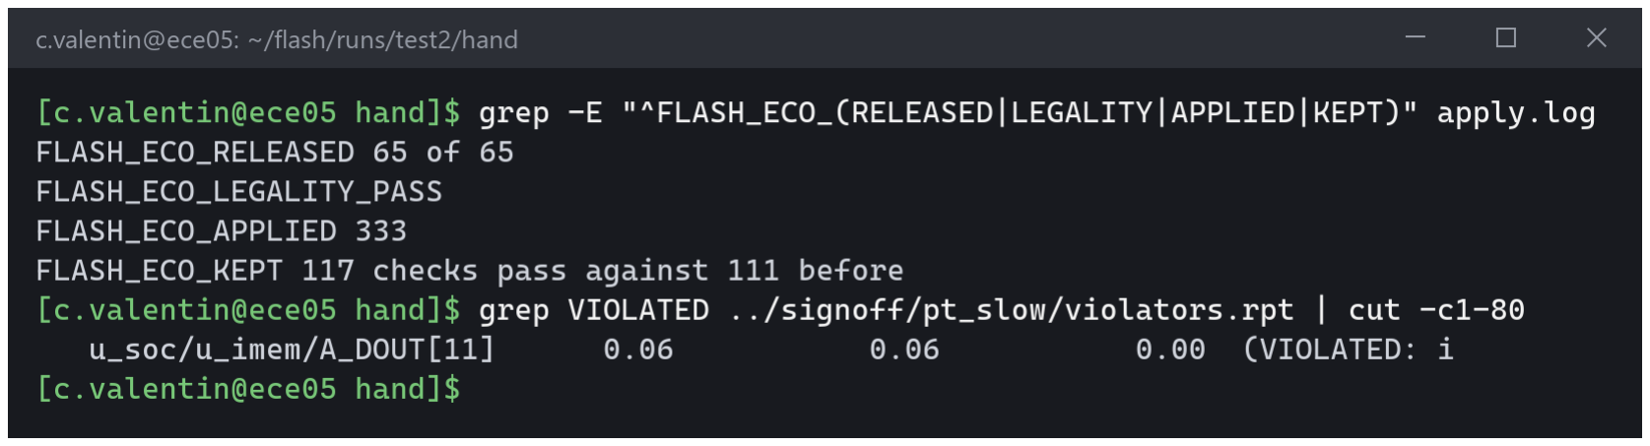
[picture p27: figure]
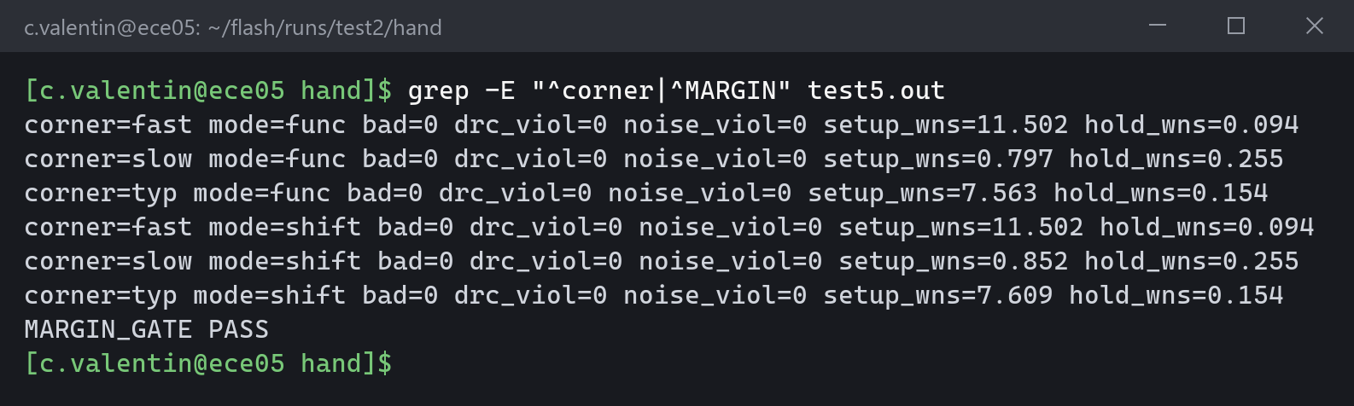
[picture p28: figure]

Building the Ibex chip on IHP SG13G2 with Synopsys | ibex-sg13g2-chip | Page 22 of 29

{ cat my_hold4.tcl; echo current_instance
echo "insert_buffer [get_pins {u_soc/u_imem/A_DOUT[15]}] sg13g2_buf_2 \ -new_net_names {net_HAND_D1} -new_cell_names {U_HAND_D1}"
echo "insert_buffer [get_pins {u_soc/u_dmem/A_DOUT[25]}] sg13g2_buf_2 \ -new_net_names {net_HAND_D2} -new_cell_names {U_HAND_D2}"
cat ~/flash/chip/margin/sclk_swap.tcl; } > my_fix.tcl
export AFTER_FC="METAL_FILL=mid bash ~/flash/flow/finish.sh . 75 bondpads" FC_CHANGES=$PWD/my_fix.tcl ~/flash/flow/eco.sh $RUN slow fc
MARGIN=hand bash ~/flash/chip/make_chip.sh my_chip # goes on to stage 8

Figure 30. The hand round's verdict on test2: kept, with 117 checks passing against 111. APPLIED counts the list plus the 9-line legality check the fix loop adds.
Fusion Compiler places and routes the changes for real, so the result can differ a little from the PrimeTime test. On test2 the kept round left the instruction memory output A_DOUT[11] at its capacitance limit, slack 0.00, in every run. make_chip.sh stopped at margin again and printed it. A one-line second list, tested and applied the same way, fixed it:

current_instance
insert_buffer [get_pins {u_soc/u_imem/A_DOUT[11]}] sg13g2_buf_2 \ -new_net_names {net_HAND_D3} -new_cell_names {U_HAND_D3}

Figure 31. The second list tested: 0 electrical violations and the gate passes.
Before you apply a later PrimeTime list, rename its new cells. Every PrimeTime session names them U_PTECO_1, U_PTECO_2 and so on, so two lists collide. margin_fix.sh shows the sed line that renames them.

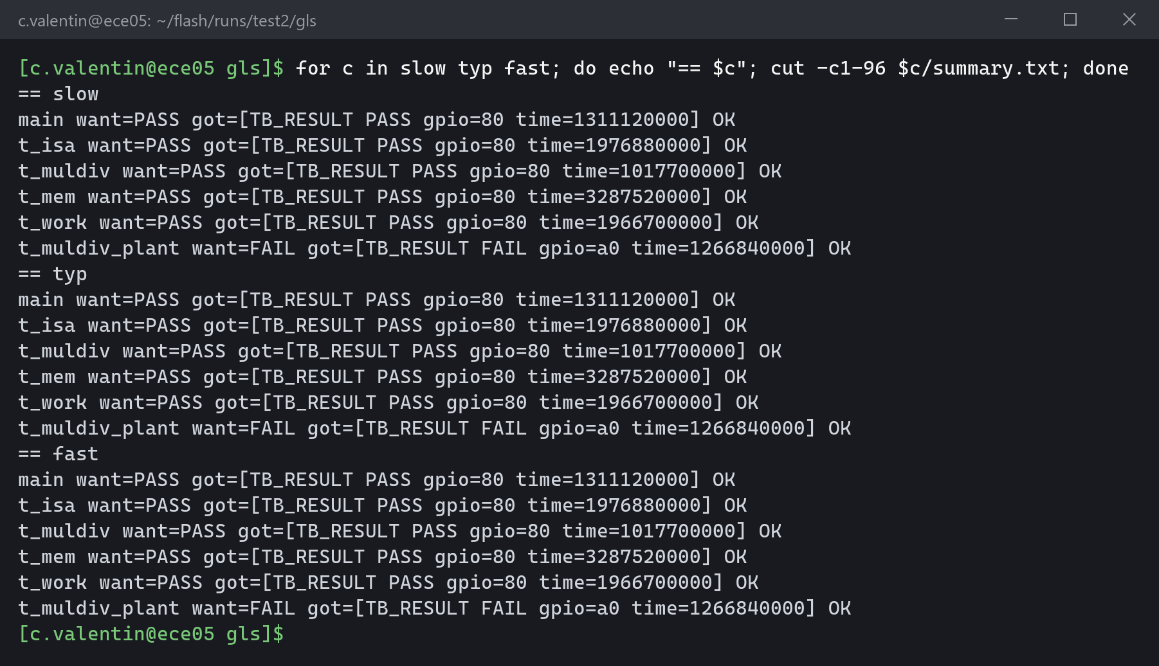
[picture p29: figure]

Building the Ibex chip on IHP SG13G2 with Synopsys | ibex-sg13g2-chip | Page 23 of 29

## Stage 8: Proving it works

nohup bash ~/flash/chip/make_chip.sh my_chip > /dev/null 2>&1 &

This runs the margin rounds of stage 7 if signoff needs them, then the four proofs below, then writes the review drafts of stage 9 and stops. Each proof is also one script you can run again by itself.

### 8.1 Programs on the gates

bash ~/flash/chip/gls.sh $RUN

VCS runs six test programs on the final netlist with PrimeTime's delays at slow, typ and fast. t_muldiv_plant is built to fail, to prove a failure would show. It passed if it prints GLS_PASS.

Figure 32. Every program at every corner, with the expected and actual result. The five real programs give 0x80 on the GPIO pins and t_muldiv_plant fails, as it must.

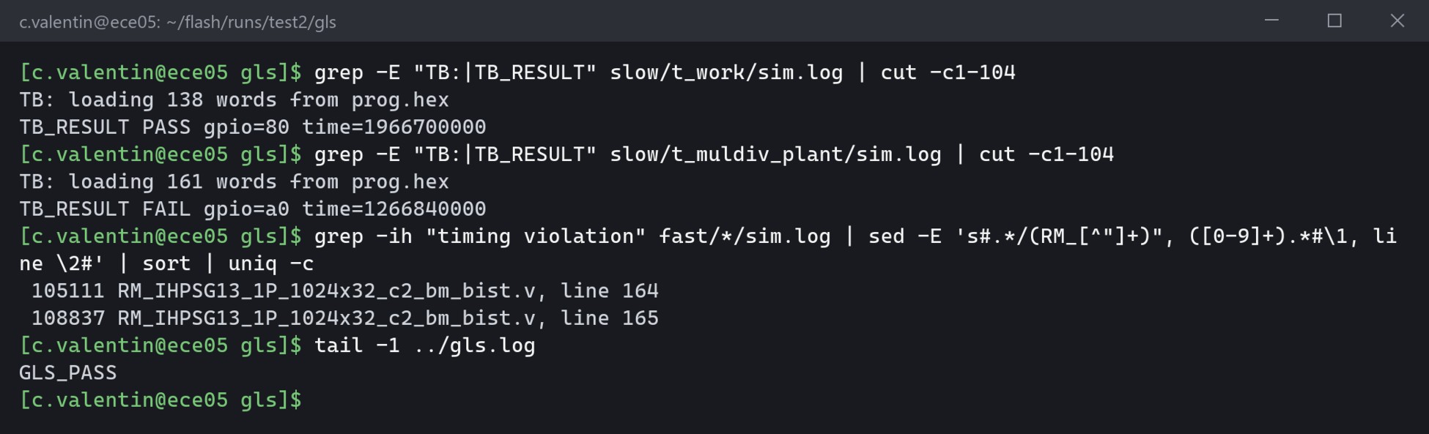
[picture p30: figure]
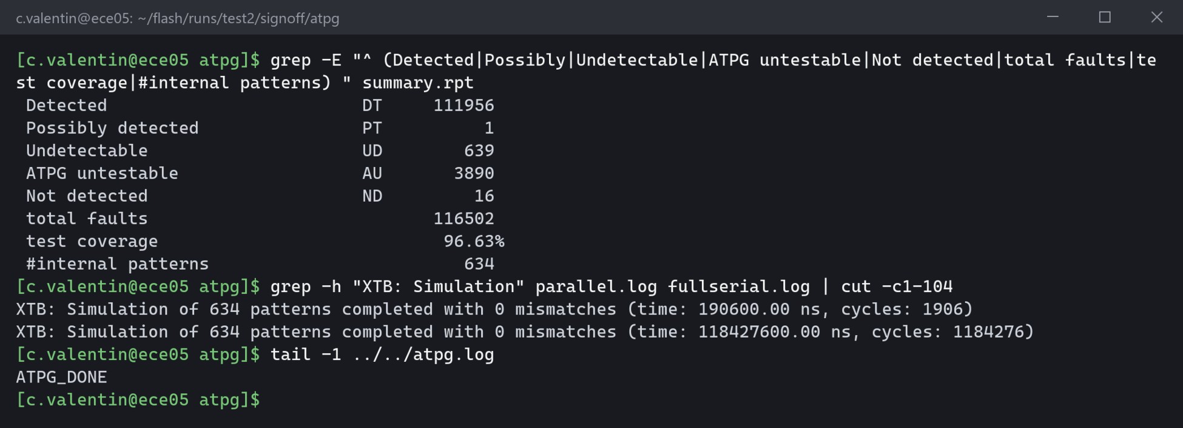
[picture p31: figure]

Building the Ibex chip on IHP SG13G2 with Synopsys | ibex-sg13g2-chip | Page 24 of 29

Figure 33. One simulation. The testbench loads the program through the serial pins and reads the result on the GPIO pins. At fast, every timing message comes from two lines of IHP's memory model.
Those two lines use a fixed 1.0 ns placeholder for address setup and hold, while IHP's characterized library gives 0.32 to 0.34 ns hold, which PrimeTime meets.

### 8.2 Scan test

bash ~/flash/chip/atpg.sh $RUN

TestMAX makes stuck-at patterns for the scan chain. VCS replays every pattern twice, loaded straight into the flip-flops and shifted serially through the scan pins as a tester would. Both replays must show 0 mismatches.

Figure 34. TestMAX's fault summary and both replays, each with 0 mismatches.
Test coverage leaves out the 639 faults that no input can make visible at an output. The patterns find wires stuck at 0 or 1. They do not reach inside the memories or test for faults that only make a path slow.

### 8.3 Clock crossings

bash ~/flash/chip/cdc.sh $RUN

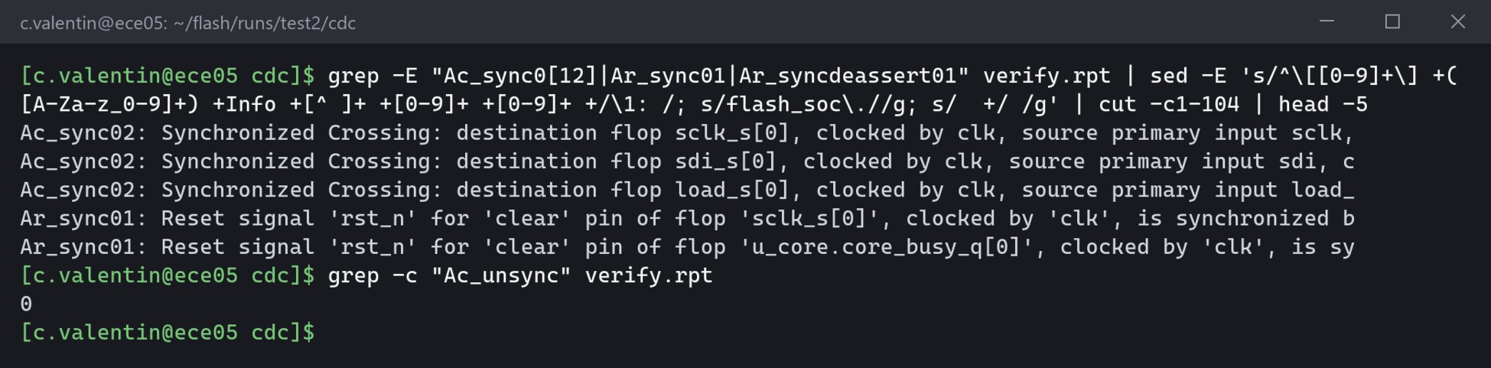
[picture p32: figure]
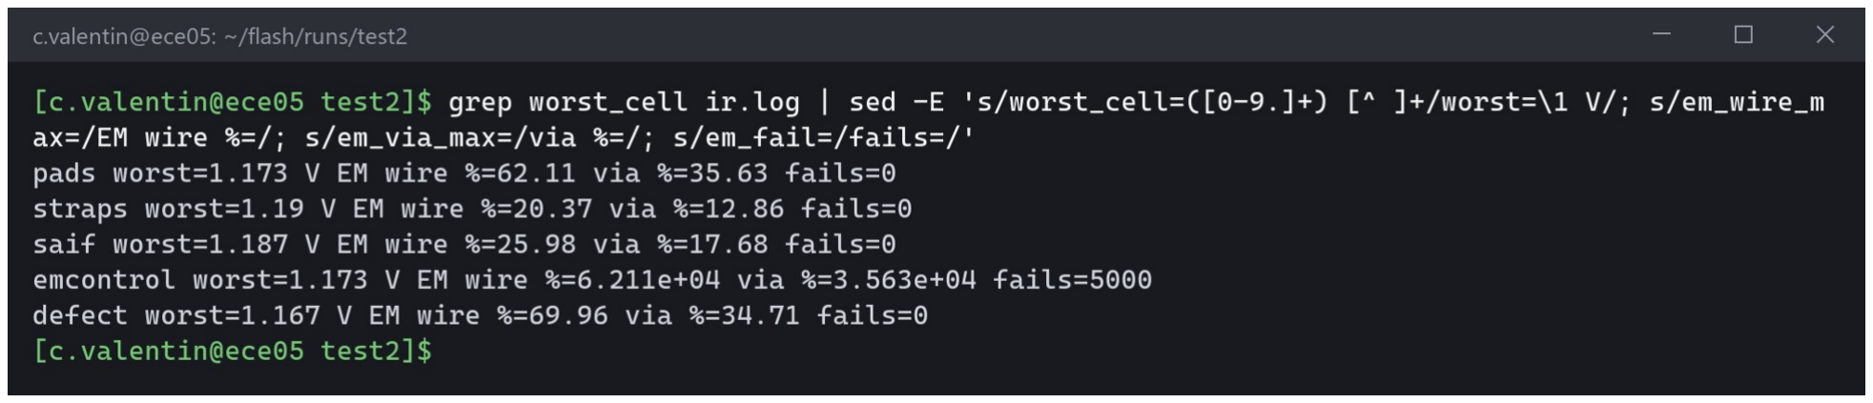
[picture p33: figure]

Building the Ibex chip on IHP SG13G2 with Synopsys | ibex-sg13g2-chip | Page 25 of 29

SpyGlass CDC checks that every signal from the test board enters the clock domain through a synchronizer. It must find 0 unsynchronized crossings.

Figure 35. Synchronizers on all three loader inputs and the reset, and 0 unsynchronized crossings.
The package datasheet gives the timing rule the test board must follow on the loader pins.

### 8.4 Voltage drop and electromigration

source /apps/settings
export ANSYSLMD_LICENSE_FILE=1055@${SNPSLMD_LICENSE_FILE#*@}
bash ~/flash/chip/ir/ir.sh $RUN

RedHawk-SC needs an Ansys license, which /apps/settings does not set. On the ECE servers it is port 1055 on the Synopsys license server, which the export line builds. Set it before make_chip.sh too, or the build skips this check and says so in its log.
RedHawk-SC checks the power grid in five cases:
- current enters only through the straps next to the supply pads
- current enters through every strap from the pad ring
- the first case again, with the switching activity of the t_work program
- a control with a weakened grid, which must look worse
- a control with limits cut 1000 times, which must fail
No real case may break an EM limit. The worst drop must stay inside the 10% allowance.

Figure 36. RedHawk-SC's result per case: the worst cell voltage on the 1.2 V supply, the worst wire and via current as a percent of IHP's limit, and the count of failing rows.

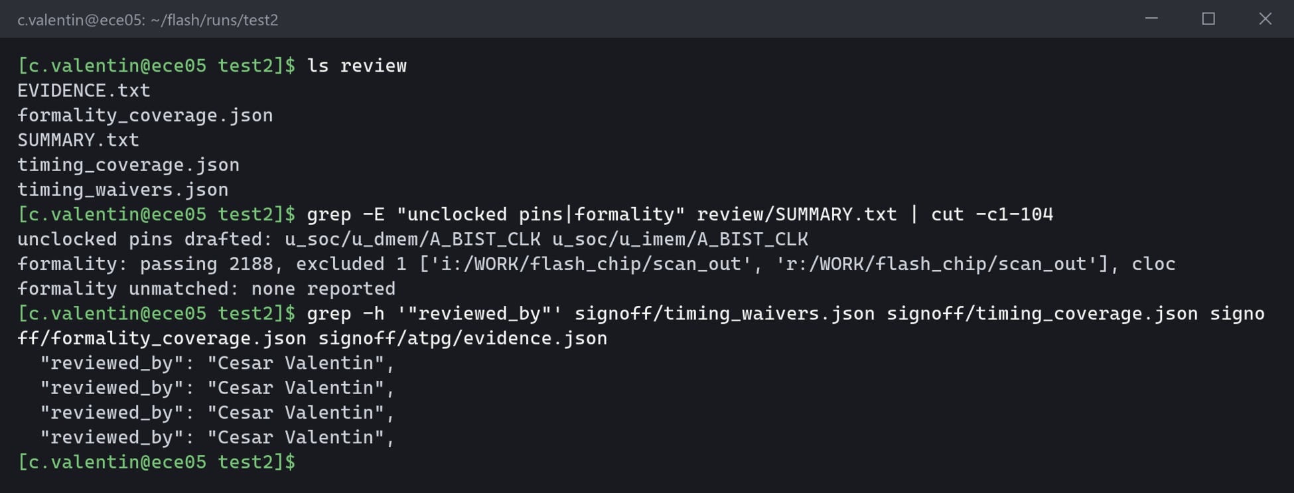
[picture p34: figure]

Building the Ibex chip on IHP SG13G2 with Synopsys | ibex-sg13g2-chip | Page 26 of 29
Case | Worst cell | Drop | Worst EM
pads only, 10% activity | 1.173 V | 27 mV, 2.3% | 62.1% of the limit
every strap, 10% activity | 1.190 V | 10 mV | 20.4%
pads only, t_work activity | 1.187 V | 13 mV, 1.1% | 26.0%
control, weakened grid | 1.167 V | 33 mV | must be worse, and is
control, limits cut 1000 times | | | all 5,000 listed rows fail, as they must

No real case breaks an EM limit, and the worst drop is far inside the allowance. The model leaves out the pad ring's own rails and the package, and does not check fast-changing current.

## Stage 9: Review records and final signoff

cat $RUN/review/SUMMARY.txt $RUN/review/EVIDENCE.txt
python3 ~/flash/chip/review/sign.py $RUN "Your Name"
bash ~/flash/chip/final_signoff.sh $RUN

Some things a tool can report but not judge. A person reads the evidence and signs a record for each. make_chip.sh leaves unsigned drafts in $RUN/review with the evidence beside them. Sign only if the evidence agrees with the basis sign.py lists. If SUMMARY.txt names an UNEXPECTED pin, do not sign until you know why that pin has no clock.

Record | What the person checks
timing_waivers.json | the two unclocked pins are the memories' unused self-test clocks
timing_coverage.json | every timing check PrimeTime skips has a reason
formality_coverage.json | the one point left out is the scan output, which the scan test covers
atpg/evidence.json | the coverage, the replays and every TestMAX warning

Figure 37. The drafts, the summary naming the two unclocked pins and the one Formality exclusion, and the four records after signing.

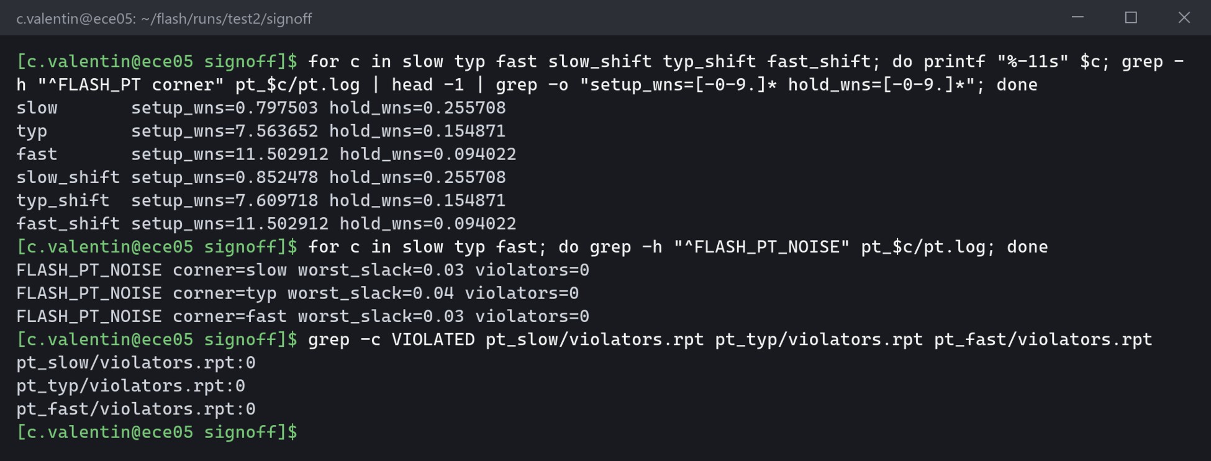
[picture p35: figure]
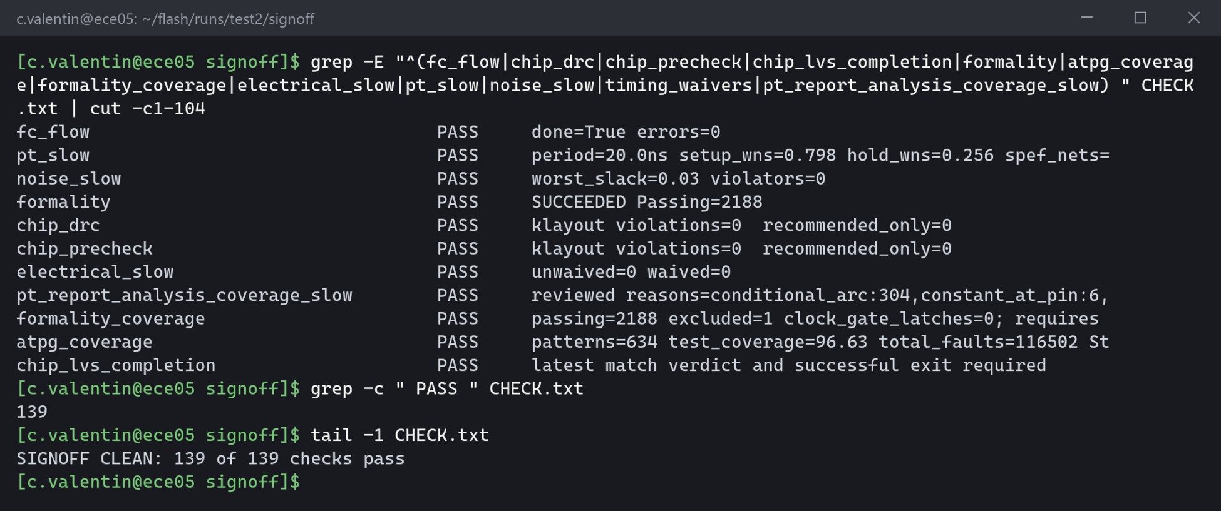
[picture p36: figure]

Building the Ibex chip on IHP SG13G2 with Synopsys | ibex-sg13g2-chip | Page 27 of 29

The signed records feed the checker, so final_signoff.sh reruns every signoff step. Stage 9 is done when the last line of signoff/CHECK.txt says SIGNOFF CLEAN.

Figure 38. PrimeTime after the final signoff: 0 noise violators and 0 electrical violations in every run.

Figure 39. The checker after the final signoff, ending in SIGNOFF CLEAN.

## Stage 10: The release package

bash ~/flash/chip/package/package.sh $RUN

It first checks that the layout and netlists match the checksums in CHECK.txt, and that the timing, parasitics and LVS files match the checksums final_signoff.sh took at the clean signoff. Then it fills IHP's release folder, $RUN/package/IHP__RVSoC8787. It saves the GDS with IHP's settings, renames the top cell to the IP name, compares that GDS shape for shape and label for label with the signed-off chip, and runs IHP's pre-check on it. It passed if it ends with PACKAGE_OK. The package's doc/Datasheet.md gives the bring-up steps.

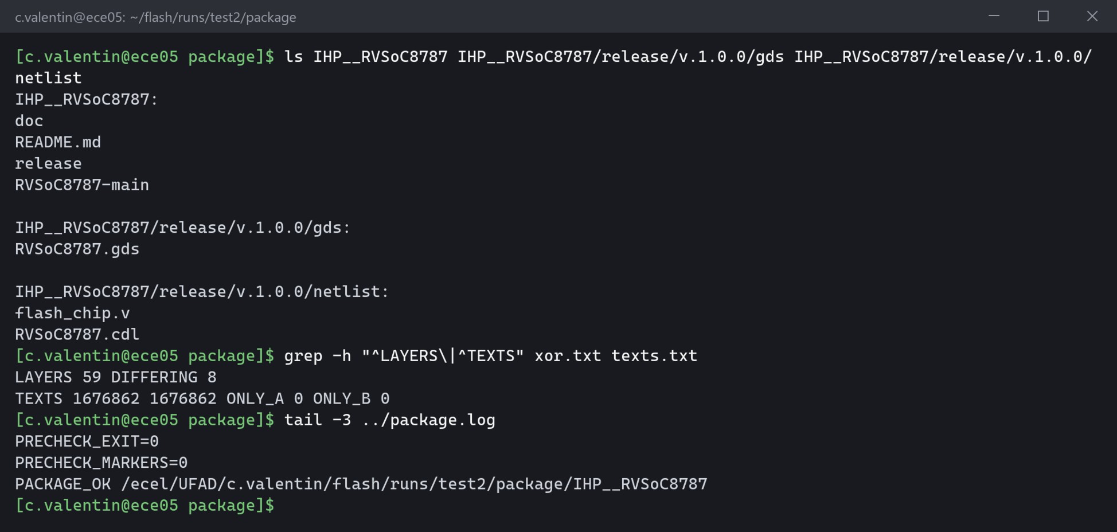
[picture p37: figure]

Building the Ibex chip on IHP SG13G2 with Synopsys | ibex-sg13g2-chip | Page 28 of 29

Figure 40. The release folder, the comparison with the signed-off chip and the package log. Every label matches, the pre-check finds no markers, and the script ends with PACKAGE_OK.
The shape log lists eight layers as differing. Each holds only labels, with 0 area and 0 polygons of difference.

## Results of the fresh build

These are the results of test2, the build fixed by hand in Stage 7.2. test1, fixed by the automatic rounds, also ended SIGNOFF CLEAN, with slow setup +0.707 ns and fast hold +0.116 ns.

Check | Result
final signoff | SIGNOFF CLEAN, 139 of 139 checks
slow setup slack | +0.797 ns at the 20 ns period
hold slack, slow, typ and fast | +0.256, +0.155 and +0.094 ns, worst of both modes
noise and electrical limits | 0 violations at every corner
Formality | 2,188 compare points pass
chip DRC and IHP pre-check | 0 and 0
block and whole-chip LVS | match
metal density | 44.6% to 55.0% on every metal layer
power | 3.45 mW at the typical corner
programs on the gates | all pass at slow, typ and fast, and the control fails
scan test | 634 patterns, 96.63% test coverage, 0 mismatches
clock crossings | 0 unsynchronized
worst static supply drop | 27 mV, 2.3%

Building the Ibex chip on IHP SG13G2 with Synopsys | ibex-sg13g2-chip | Page 29 of 29
Check | Result
worst EM | 62.1% of IHP's limit
die size | 1708 by 1753 µm

This signoff leaves three things unproven. IHP publishes no factory-qualified worst and best wire models. LVS does not check inside IHP's memory and pad cells. The voltage-drop check is static only.

## Labs

Once your first chip is through place and route, docs/ibex-labs.pdf has six experiments that each change one setting: routing layers, the clock target, the real clock, a placement blockage, wire spacing and redundant vias. Each gives its commands, what to look at and the measured result. chip/compare_runs.sh puts any runs side by side.

## Command summary

git clone https://github.com/XxMasterepicxX/ibex-sg13g2-chip.git ~/flash
bash ~/flash/setup/setup.sh | once, about two hours
source /apps/settings
export ANSYSLMD_LICENSE_FILE=1055@${SNPSLMD_LICENSE_FILE#*@} | for stage 8.4
nohup bash ~/flash/chip/make_chip.sh my_chip & | makes the run, then stages 3 to 8
RUN=~/flash/runs/my_chip
python3 ~/flash/chip/review/sign.py $RUN "Your Name" after reading the drafts
bash ~/flash/chip/final_signoff.sh $RUN | ends with SIGNOFF CLEAN
bash ~/flash/chip/package/package.sh $RUN | ends with PACKAGE_OK
