XxMasterepicxX/ibex-sg13g2-chip/(commit log)

2026-10-05 Ibex on IHP SG13G2: setup, flow, chip scripts and documents
2026-10-06 Clock tree DRC fix, by-hand margin path, faster finishing and signoff, cleanup
    - Reroute the clock nets with route_eco after the decaps: 0 clock route DRCs instead of 189.
    - MARGIN=hand stops make_chip.sh at margin; chip/margin/test_list.sh tests a hand-written change list.
    - finish.sh and signoff.sh run the independent KLayout checks at once, about 1.5 hours less per finish and signoff.
    - signoff.sh finds the worst and best wire models itself, now in ihp/rc/rcmax and ihp/rc/rcmin.
    - Metal fill defaults to mid and stops on a missing fill macro.
    - Renames: flow/eco.sh, flow/make_pt_policy.py, designs/flash_soc/rtl, ihp/fill/fill.py.
    - Comments without old run history; code for other process k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
    [flash_chip.v, flash_soc.v]
2026-10-06 Flow document: name the clock tree style and why DRC and LVS use KLayout
2026-10-06 Fix fresh setup; run the flow stage by stage
    - setup/build_libs.sh: grdgenxo's exit code ended the wire-model step under set -e, so every fresh setup stopped at
    SETUP_FAIL build_libs and only a rerun passed. Each step is now judged by the file it writes.
    - make_chip.sh: STOP_AT=synth|route|finish|signoff|proofs stops after one stage, and every stage logs the command it runs.
    - chip/open_fc.sh opens a saved step read-only in Fusion Compiler; chip/open_klayout.sh opens the finished chip in KLayout.
    - docs/ibex-flow.pdf: run it stage by stage, what to look at after each stage, and labs that change one setting.
2026-10-06 Flow document: results of the three labs
2026-10-06 Failures stop the flow instead of passing; packaging checks the signed-off files
    - gls.sh: each corner must judge all six programs OK; a failed or missing simulation is GLS_FAIL.
    - final_signoff.sh: fails if the ATPG restamp fails, needs a new CHECK.txt, and exits non-zero unless SIGNOFF CLEAN.
    - package.sh: refuses to package if any file the checker signed off has changed since; copies the testbench, the
    simulation script and every test program with its built image.
    - make_chip.sh: signoff counts as done only when every tool finished, so a failed tool is retried; the proofs stop
    is gone, since it stopped before the review drafts.
    - finish.sh: done only when chip DRC and the precheck pas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
2026-10-07 Margin rounds learn from an undone round
    A round is undone when real routing makes a new noise victim that PrimeTime's estimate did not show, and the next
    round used to propose the same list again. eco.sh now keeps the undone attempt's noise report; the next round of
    margin_fix.sh has PrimeTime find those victims' drivers and buffers them before testing its list, and moves the
    report into its own folder so no later round uses it again.
2026-10-07 DRC cannot hang or pass by accident; packaging checks every file it ships
    - flow/drc.sh runs IHP's run_drc.py for chip finishing, block signoff and the release precheck. KLayout's deep
    mode now and then stalls on one check for hours, so a run past DRC_TIME_LIMIT (150 min) is stopped and run once
    more; KLayout ignores SIGTERM, so the whole process group gets SIGKILL. A deck that crashes counts as a failure,
    since run_drc.py still exits 0 then.
    - finish.sh waits for each DRC job and never reuses an old exit file.
    - final_signoff.sh hashes the LVS netlist, SDFs and SPEFs at a clean signoff; package.sh ships them only if all
    seven still match.
2026-10-07 Undoing a margin round cannot break the run; DRC never leaves workers behind
    - eco.sh used to delete the failed attempt and then move the saved run back. On NFS a folder that holds a file
    some process still has open cannot be deleted, so the move was skipped and the run lost its layout and signoff.
    The attempt is now moved aside first, the saved run moved back, and the attempt deleted last; a failed move
    puts everything back and stops with FLASH_ECO_FAILED.
    - drc.sh kills its whole process group when the run ends, when it times out, and when it is interrupted or hung
    up, so no KLayout worker keeps files open in the run folder.
